RepRapLtd/Mendel-V1.0/Modified designs/Pix/20240402_110909.jpg

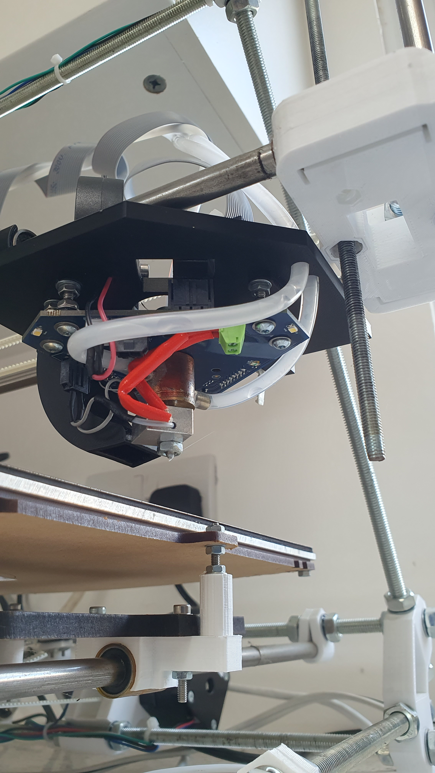
Modified designs/Pix/20240402_110909.jpg
