RepRapLtd/Mendel-V1.0/Modified designs/Pix/20240402_110834.jpg

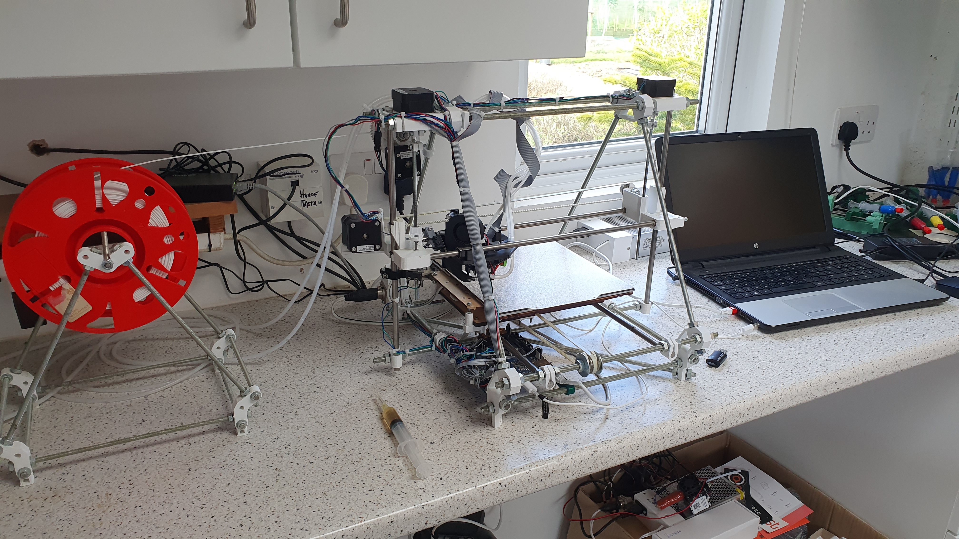
Modified designs/Pix/20240402_110834.jpg
