RepRapLtd/Mendel-V1.0/README

This is the RepRapPro Ltd version of Mendel.

See here for more details: http://reprappro.com/Mendel

See also the file dev-notes.
