RepRapLtd/Mendel-V1.0/gEDA/Heatbed/heatbed.png

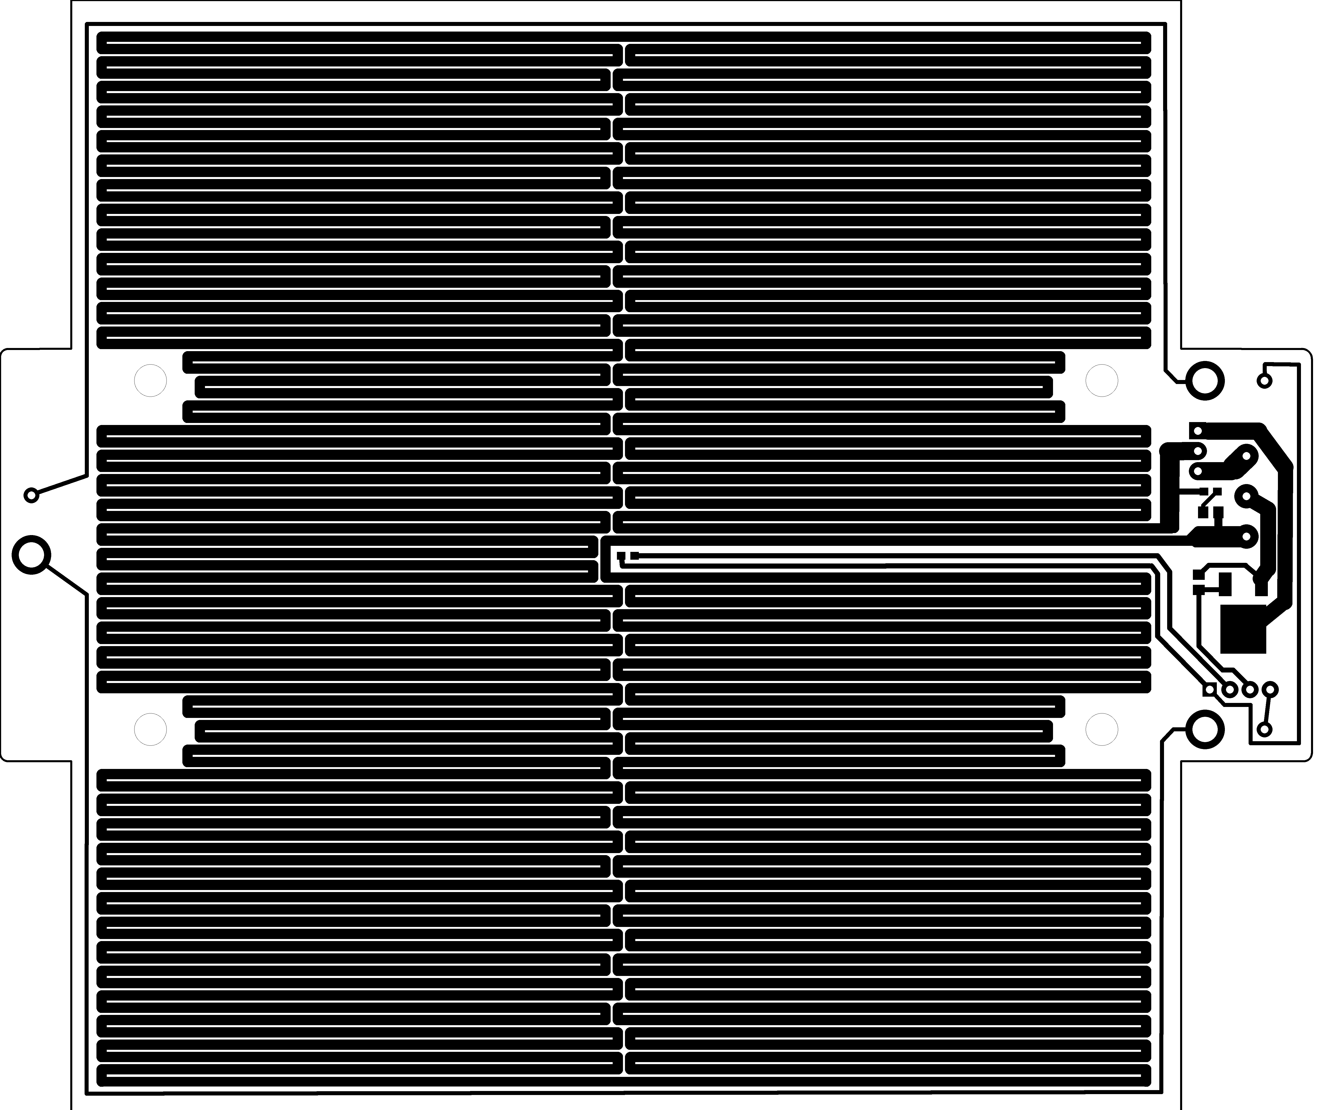
gEDA/Heatbed/heatbed.png
