RepRapLtd/Mendel-V1.0/Mult-material/README

RepRapPro Multi-material Mendel
===============================

These are the design files for the RepRapPro Multi-material Mendel.

This is work in progress.

http://reprappro.com
