RepRapLtd/Mendel-V1.0/RepRapPro-Mendel-BoM.ods

Sheet: Frame
Item | No off | Notes
 | Triangles
370mm M8 rods | 6 | 290mm between faces
Printed Frame vertex w. foot | 4
Printed Frame vertex | 2
U clips | 2
M8 nuts | 28
M8 lock washers | 28
 | X Links
330mm M8 rods | 4 | 273mm between faces
470mm M8 rods | 2
Printed U clips | 4
M8 mudguard washers | 2
M8 bearings | 2
M8 lock washers | 8
M8 washers | 28
M8 nuts | 46
M8 nuts | 12
M8 lock washers | 24
Printed XLR holder | 1
470mm M8 rods | 2
Printed Z motor holders | 2
Printed U clips | 2
M8 nuts | 12
M8 lock washers | 10
M8 washers | 6
XLR panel plug | 1
12mm M3 caps | 2
M3 washers | 2
M3 nuts | 2
400mm smooth rods (Y) | 2
350mm smooth rods (Z) | 2

Sheet: Y axis
Item | No off | Notes
 | Motor + mount
Printed Y motor mount | 1 | Nuts – 73mm from left
Printed Y motor lid | 1
Nema 17 motor | 1
M3 x 35mm screws | 3
M3 x 10mm set screw | 1
M3 nut | 1
M3 x 8mm screws | 2
Toothed belt pulley | 1
M3 washers | 3
 | Frog
Lasercut frog | 1 | Nuts – 22mm from left
LM8UU bearings | 3 | 175mm between Y rods
Printed bearing holders | 3
Printed 7mm belt clamps | 3
Printed belt guide | 1
Printed 4mm ridged belt clamp | 1
Printed ridged belt adjuster | 1
M3 x 35mm screws | 2
M3 x 30mm screws | 2
M3 x 20mm screws | 7
M3 nylock nut | 1
M3 nuts | 10
M3 washers | 20
 | Belt and stop
Toothed belt | 850mm
Printed XY endstop holder | 1
microswitch | 1
M2.5x15mm screws | 2
M2.5 washers | 4
M2.5 nuts | 2
M3x20mm screw | 1
M3 washers | 2
M3 nuts | 1

Sheet: X-axis
Item | No off | Notes
 | X carriage
Printed X carriage lid | 1
Printed X carriage plate | 1
Printed X belt clamp | 2
Cardboard heatshield | 1
Aluminium cooking foil | 110mm x 135mm
LM8UU bearings | 3
M3x20mm screws | 5
M3x35mm screws | 5
M3x30mm hex-head screws | 3
M3 nylock nut | 1
M3 nuts | 22
M3 washers | 27
 | Axis
Printed Xend motor | 1
Printed X end idler | 1
428mm smooth 8mm rods (X) | 2 | +0/-1 mm
8mm IGUS bearings | 4
M3 nylock nuts | 2
M3x16 screws | 2
 | Motor
NEMA 17 motor | 1
M3x10 screws | 4
M3 washers | 4
Toothed belt pulley | 1
M3 x 10mm set screw | 1
 | Idler
M8 threaded rod | 35mm
M8 nuts | 2
M8 mudguard washer | 1
8mm bearing | 1
M8 washers | 3

Sheet: Z-axis
Item | No off | Notes
 | Z drive
NEMA 17 motors | 2
60 mm springs | 2 | 0.5 wire, 7mm od
215mm M5 studding | 2
M5 nuts | 4
30mm x 5mm id poly tube | 2
Printed U clamps | 4
M3 x 20mm screws | 4
M3 nuts | 4
M3 x 10mm screws | 8
M3 washers | 12
 | Z endstop
M2.5x15mm screws | 2
M2.5 washers | 4
M2.5 nuts | 2
microswitch | 1
Printed Z-stop bracket | 1
Printed z-adjust wheel | 1
M3 x 35mm hex-head screw | 1
M3 x 20mm screws | 1
M3 nuts | 3
M3 washers | 4
15mm spring | 1 | 0.4 wire, 4.5mm od
 | X belt and endstop
Printed XY-stop bracket | 1
M2.5x15mm screws | 2
M2.5 washers | 4
M2.5 nuts | 2
microswitch | 1
M3 x 20mm screws | 1
M3 nuts | 1
M3 washers | 2
toothed belt | 1000mm

Sheet: Heated bed
Item | No off | Notes
Lasercut insulator | 1
PCB bed heater | 1
Glass printing plate | 1
Spring clips | 4
M3 x 50mm screws | 3
40mm springs | 3 | 0.6mm wire, 5.5mm od
M3 nuts | 9
M3 washers | 12
glue sachet | 1
thermistor | 1
heatshrink | 50mm
twin ribbon | 300mm

Sheet: Extruder drive
Item | No off | Notes
 | Motor and hobbed stud assembly | Same as Huxley, except for the fitting components, the 4mm PTFE, and the M4 bowden ends
M6 hobbed stud | 1
M6 full nut | 1
M6 nyloc nut | 2
M6 split washer | 1
M6 plain washer | 2
626 Bearing | 2
NEMA 14 stepper motor | 1
M3x10mm socket set screw | 1
M3 nut | 1
M3x8mm screws | 3
Printed M6 drive block | 1
Printed large gear | 1
Printed small gear | 1
 | Idler
M3x30mm screw | 1
626 bearing | 1
M3x45 screws | 2
M6x20mm socket set screw | 1
M3 washers | 6
M3 full nuts | 2
M3 nylock nut | 1
Springs | 2
Printed idler | 1
 | The Bowden tube
slotted brass retainer | 1 | M4 not M3
PTFE tube | 1
Printed tongue | 1
 | Fitting
M3 x 35mm screw | 1
M3x25mm countersunk screw | 1
M3 washers | 3
M3 nuts | 2
Printed extruder drive mount | 1
Printed PCB clip | 1

Sheet: Hot end
Item | No off | Notes
 |  | Same as Huxley except for brass union
Fan and heatsink | 1
Aluminium heater block | 1
M3x25 screws | 2
M3x16 screws | 2
Cable ties | 2
Stainless steel barrel | 1
M6 nyloc nut | 2
M6 split washer | 1
Brass union | 1 | M4 not M3
Brass nozzle | 1
100K thermistor | 1
6R8 heater resistor | 1
PTFE insulating cone | 1
PTFE spacer | 1
Aluminium cooling block | 1
connecting wire 20mm lengths | 4
crimps | 4
Heatshrink sleeve | 1
3mm PTFE tube (insert) | 15mm

Sheet: Wiring
Item | No off | Notes
Melzi PCB | 1
Printed PCB mounts | 3
M3 x 20mm screws | 3
M3 washers | 6
M3 nuts | 3
20A wire | 2m
heatshrink | 200mm
USB A to min B cable | 1
SD card + adapter | 1
12v Power supply | 1
Mains cable | 1
XLR line socket (metal shell) | 1
Cable ties | 100
PS shields/feet etc | ?

Sheet: Totals
sort | Item | No off
1 | 370mm M8 rods | 6 | 6
1 | M8 nuts | 100 | 28 | 46 | 12 | 12 | 2
1 | M8 lock washers | 70 | 28 | 8 | 24 | 10
1 | 330mm M8 rods | 4 | 4
1 | 470mm M8 rods | 2 | 2
1 | M8 mudguard washers | 3 | 2 | 1
1 | M8 washers | 37 | 28 | 6 | 3
1 | 470mm M8 rods | 2 | 2
1 | M3x12mm screws | 2 | 2
1 | M3 washers | 103 | 2 | 3 | 20 | 2 | 27 | 4 | 12 | 4 | 2 | 12 | 6 | 3 | 6
1 | M3 nuts | 61 | 2 | 1 | 10 | 1 | 22 | 4 | 3 | 1 | 9 | 1 | 2 | 2 | 3
1 | 400mm smooth rods (Y) | 2 | 2
1 | 350mm smooth rods (Z) | 2 | 2
1 | M3 x 35mm screws | 11 | 3 | 2 | 5 | 1
1 | M3 x 10mm set screw | 2 | 1 | 1
1 | M3 x 8mm screws | 5 | 2 | 3
1 | M3 x 30mm screws | 3 | 2 | 1
1 | M3 x 20mm screws | 21 | 7 | 1 | 3 | 4 | 1 | 1 | 1 | 3
1 | M3 nylock nut | 5 | 1 | 1 | 2 | 1
1 | M2.5x15mm screws | 6 | 2 | 2 | 2
1 | M2.5 washers | 12 | 4 | 4 | 4
1 | M2.5 nuts | 6 | 2 | 2 | 2
1 | M3x30mm hex-head screws | 3 | 3
1 | 428mm smooth 8mm rods (X) | 2 | 2
1 | M3x16 screws | 4 | 2 | 2
1 | M3x10 screws | 13 | 4 | 8 | 1
1 | 35mm M8 threaded rod | 1 | 1
1 | 215mm M5 studding | 2 | 2
1 | M5 nuts | 4 | 4
1 | M3 x 35mm hex-head screw | 1 | 1
1 | M3 x 50mm screws | 3 | 3
1 | M6 full nut | 1 | 1
1 | M6 nyloc nut | 4 | 2 | 2
1 | M6 split washer | 2 | 1 | 1
1 | M6 plain washer | 2 | 2
1 | M3x45 screws | 2 | 2
1 | M3x25mm countersunk screw | 1 | 1
1 | M3x25 screws | 2 | 2
2 | Printed Frame vertex w. foot | 4 | 4
2 | Printed Frame vertex | 2 | 2
2 | Printed U clips | 8 | 2 | 2 | 4
2 | Printed tube U clips | 4 | 4
2 | Printed XLR holder | 1 | 1
2 | Printed Z motor holders | 2 | 2
2 | Printed Y motor mount | 1 | 1
2 | Printed Y motor lid | 1 | 1
2 | Lasercut frog | 1 | 1
2 | Printed bearing holders | 3 | 3
2 | Printed 7mm belt clamps | 3 | 3
2 | Printed belt guide | 1 | 1
2 | Printed 4mm ridged belt clamp | 1 | 1
2 | Printed ridged belt adjuster | 1 | 1
2 | Printed XY endstop holder | 1 | 1
2 | Printed X carriage lid | 1 | 1
2 | Printed X carriage plate | 1 | 1
2 | Printed X belt clamp | 2 | 2
2 | Cardboard heatshield | 1 | 1
2 | Printed Xend motor | 1 | 1
2 | Printed X end idler | 1 | 1
2 | Toothed belt pulley | 2 | 1 | 1
2 | Printed Z-stop bracket | 1 | 1
2 | Printed z-adjust wheel | 1 | 1
2 | Printed XY-stop bracket | 1 | 1
2 | Printed M6 drive block | 1 | 1
2 | Printed large gear | 1 | 1
2 | Printed small gear | 1 | 1
2 | Printed idler | 1 | 1
2 | Printed tongue | 1 | 1
2 | Printed extruder drive mount | 1 | 1
2 | Printed PCB mounts | 4 | 3 | 1
3 | M8 bearings | 3 | 2 | 1
3 | LM8UU bearings | 6 | 3 | 3
3 | Toothed belt (mm) | 1850 | 850 | 1000
3 | Aluminium cooking foil | 0 | 110mm x 135mm
3 | 8mm IGUS bearings | 4 | 4
3 | 60 mm springs | 2 | 2
3 | 30mm x 5mm id poly tube | 2 | 2
3 | 15mm spring | 1 | 1
3 | Lasercut insulator | 1 | 1
3 | Glass printing plate | 1 | 1
3 | Spring clips | 4 | 4
3 | 40mm springs | 3 | 3
3 | glue sachet | 1 | 1
3 | M6 hobbed stud | 1 | 1
3 | 626 Bearing | 3 | 2 | 1
3 | Springs | 2 | 2
3 | slotted brass retainer | 1 | 1
3 | PTFE tube | 1 | 1
3 | Aluminium heater block | 1 | 1
3 | Cable ties | 100 | 2 | 98
3 | Stainless steel barrel | 1 | 1
3 | Brass union | 1 | 1
3 | Brass nozzle | 1 | 1
3 | PTFE insulating cone | 1 | 1
3 | PTFE spacer | 1 | 1
3 | Aluminium cooling block | 1 | 1
3 | 3mm PTFE tube (insert – mm) | 15 | 15
4 | XLR panel plug | 1 | 1
4 | Nema 17 motor | 4 | 1 | 1 | 2
4 | microswitch | 3 | 1 | 1 | 1
4 | PCB bed heater | 1 | 1
4 | thermistor | 1 | 1
4 | Heatshrink (mm) | 50 | 50
4 | twin ribbon (mm) | 300 | 300
4 | NEMA 14 stepper motor | 1 | 1
4 | Fan and heatsink | 1 | 1
4 | 100K thermistor | 1 | 1
4 | 6R8 heater resistor | 1 | 1
4 | connecting wire 20mm lengths | 4 | 4
4 | crimps | 4 | 4
4 | Heatshrink sleeve (mm) | 300 | 100 | 200
4 | Melzi PCB | 1 | 1
4 | 20A wire (m) | 2 | 2
4 | USB A to min B cable | 1 | 1
4 | SD card + adapter | 1 | 1
4 | 12v Power supply | 1 | 1
4 | Mains cable | 1 | 1
4 | XLR line socket (metal shell) | 1 | 1
4 | PS shields/feet etc | 0 | ?
