RepRapLtd/Mendel-V1.0/dxf/cardboard-heat-shield.dxf

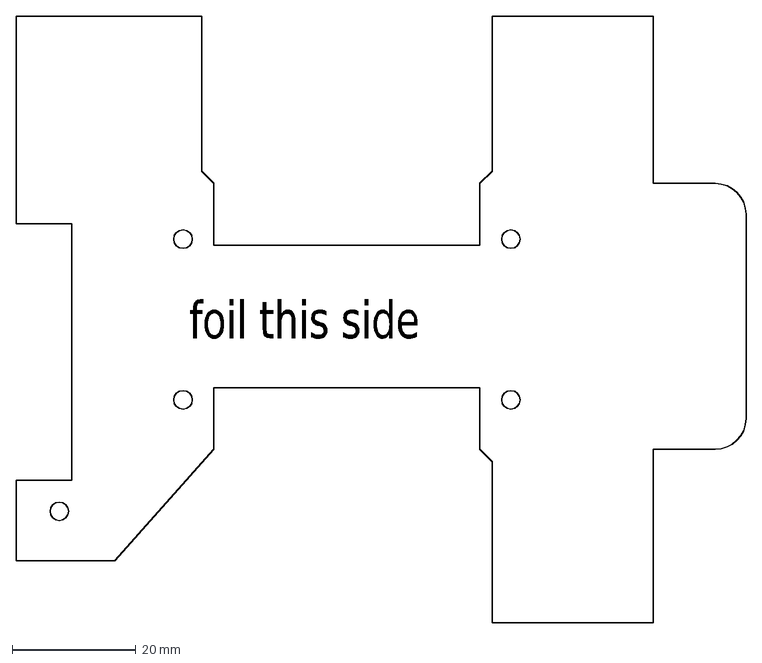
[picture p5: CAD file, 2020-08-14]
dxf/cardboard-heat-shield.dxf
foil this side
