RepRapLtd/Mendel-V1.0/Modified designs/STLs/switch-probe-x-carriage-lever.stl

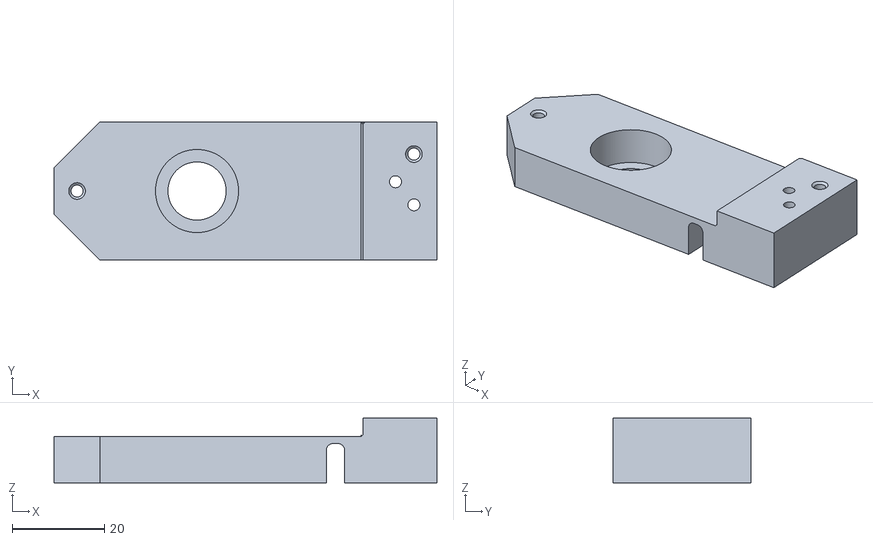
[picture p6: CAD file, 2024-06-14]
Modified designs/STLs/switch-probe-x-carriage-lever.stl
83.0 x 30.0 x 14.0
