RepRapLtd/Mendel-V1.0/Modified designs/switch-probe-x-carriage.FCStd

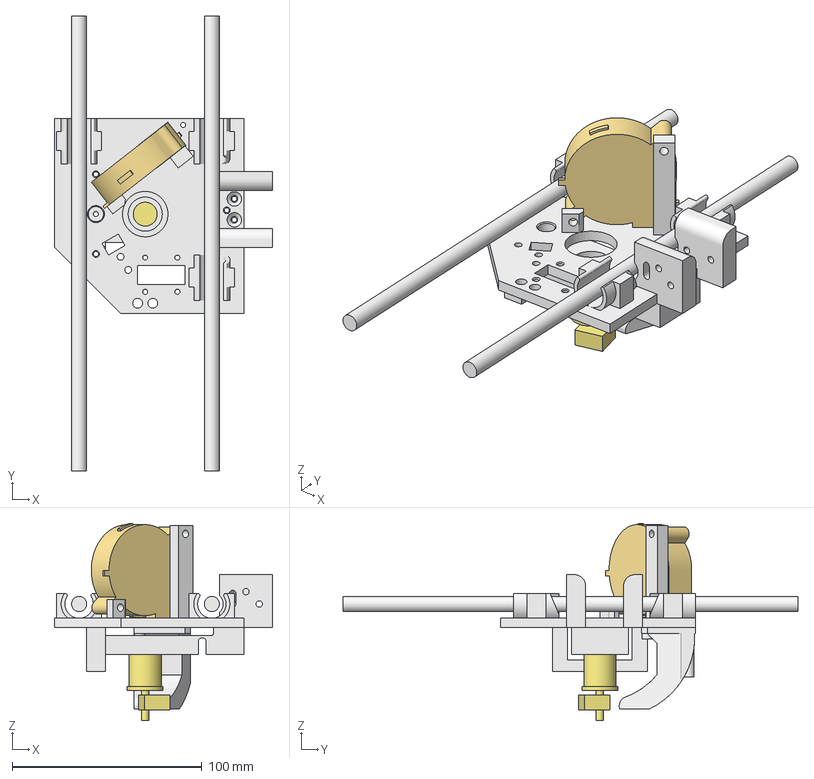
[picture p7: CAD file, 2024-06-14]
Modified designs/switch-probe-x-carriage.FCStd
115.0 x 240.0 x 104.0 mm
8mm rod-1
8mm rod 2
hot-end
duct-j
lever
carriage
contact-bridge
snail-fan
