RepRapLtd/Mendel-V1.0/Mult-material/Print-mendel-mult-material/Individual-STLs/small-gear-1off.stl

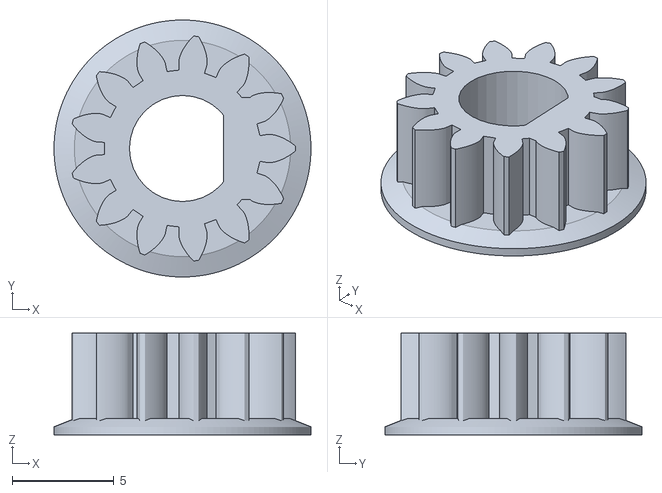
[picture p8: CAD file, 2020-08-14]
Mult-material/Print-mendel-mult-material/Individual-STLs/small-gear-1off.stl
12.6 x 12.6 x 5.00
