RepRapLtd/Mendel-V1.0/Openscad/x-carriage.FCStd

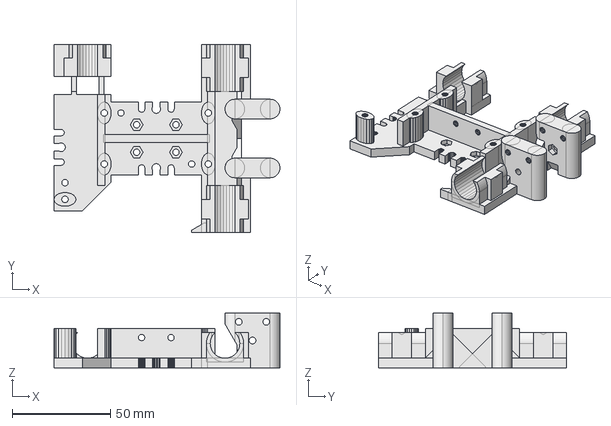
[picture p9: CAD file, 2023-07-14]
Openscad/x-carriage.FCStd
115.1 x 96.0 x 28.0 mm
