RepRapLtd/Mendel-V1.0/Print-mendel/Mendel-trays-STLs/Tray-1/Tray1B.stl

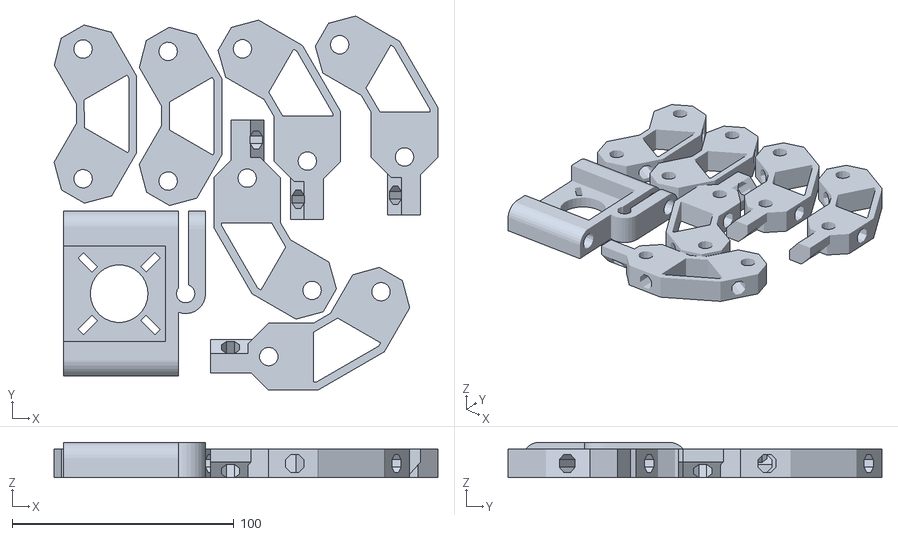
[picture p10: CAD file, 2020-08-14]
Print-mendel/Mendel-trays-STLs/Tray-1/Tray1B.stl
173.2 x 168.7 x 16.0
