RepRapLtd/Mendel-V1.0/Print-mendel/Mendel-trays-STLs/Tray-2/Tray2B.stl

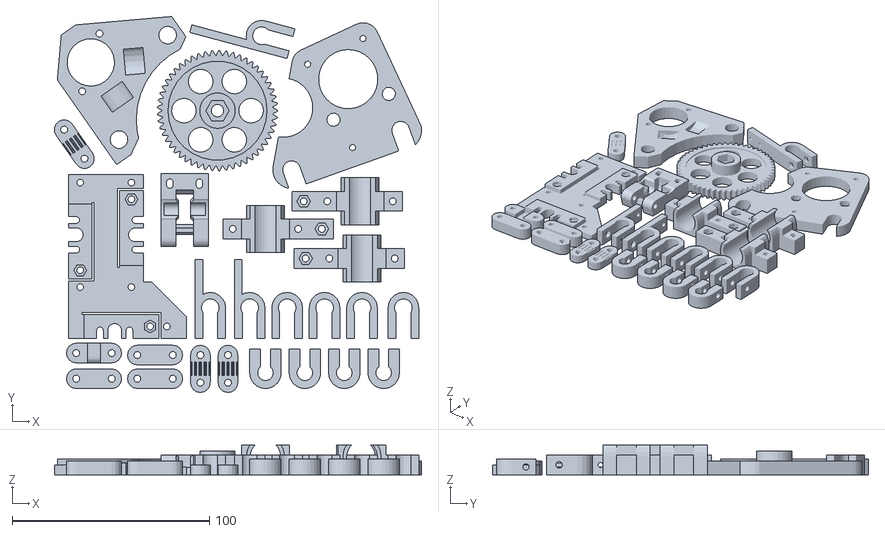
[picture p11: CAD file, 2020-08-14]
Print-mendel/Mendel-trays-STLs/Tray-2/Tray2B.stl
186.3 x 190.8 x 15.0
