RepRapLtd/Mendel-V1.0/Print-mendel/Mendel-trays-STLs/Tray-3/Tray3B.stl

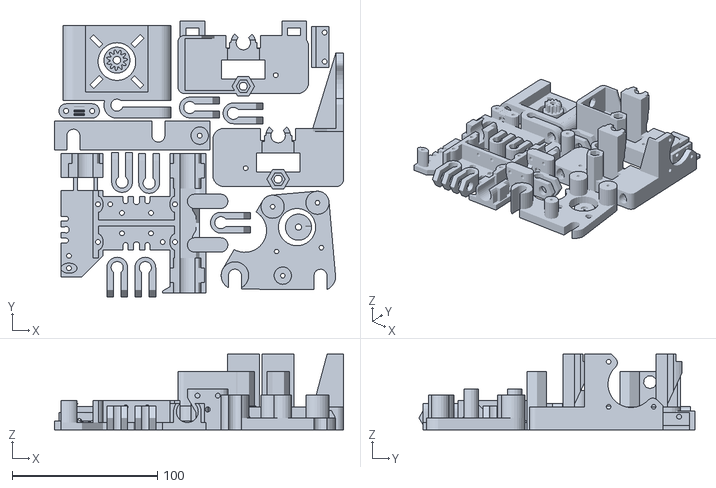
[picture p12: CAD file, 2020-08-14]
Print-mendel/Mendel-trays-STLs/Tray-3/Tray3B.stl
199.0 x 190.1 x 52.0
