RepRapLtd/Mendel-V1.0/Quickset-x-carriage/x-carriage-and-lid.FCStd

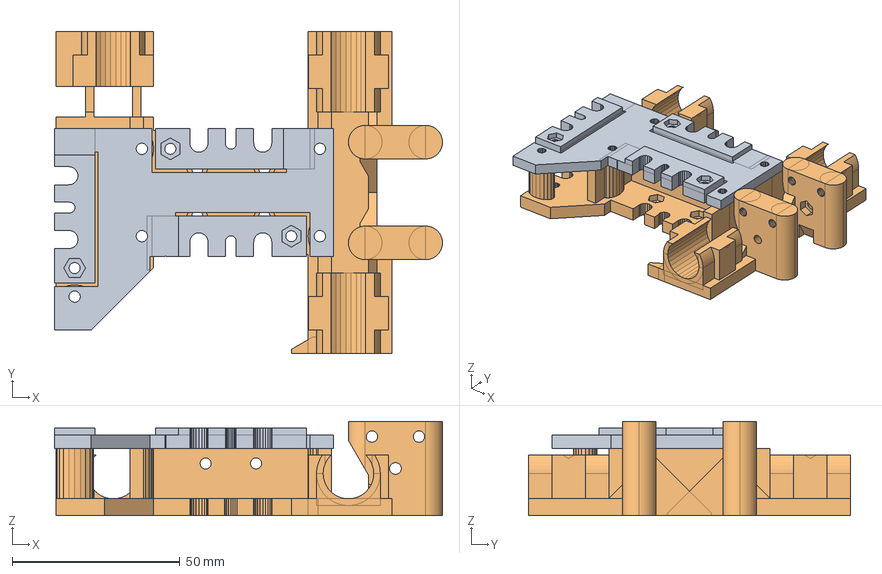
[picture p13: CAD file, 2020-08-18]
Quickset-x-carriage/x-carriage-and-lid.FCStd
115.5 x 96.0 x 28.0 mm
x-lid
x-carriage
