RepRapLtd/Mendel-V1.0/dxf/ybracproject.dxf

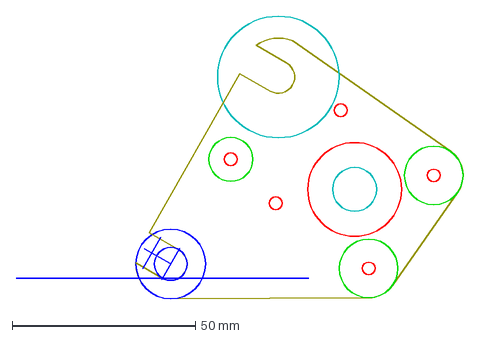
[picture p14: CAD file, 2020-08-14]
dxf/ybracproject.dxf
123.2 x 77.2 mm
