RepRapLtd/Mendel-V1.0/Modified designs/smart-effector-x-carriage.FCStd

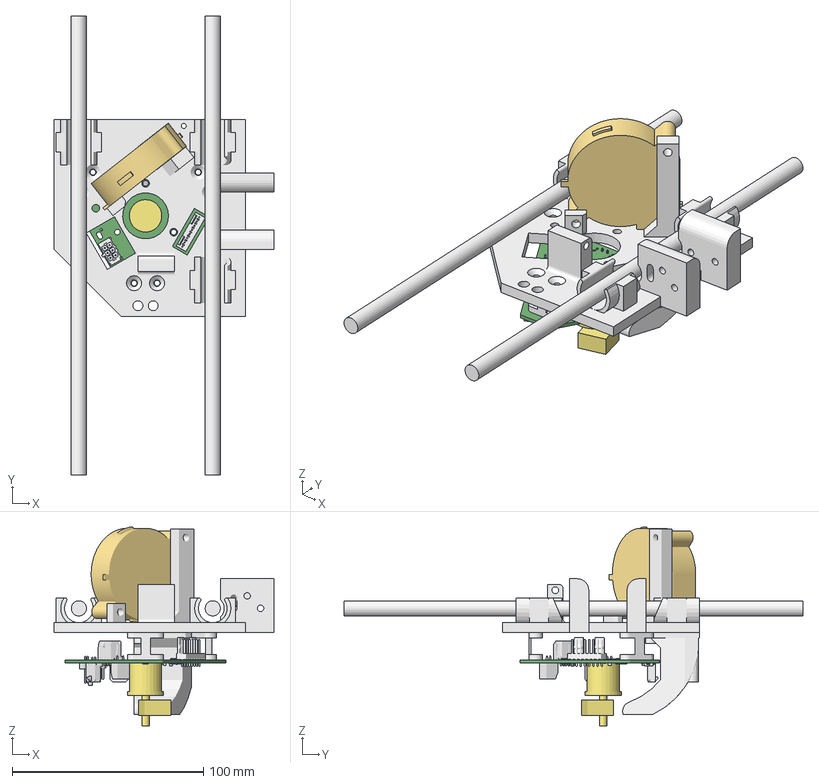
[picture p15: CAD file, 2024-03-04]
Modified designs/smart-effector-x-carriage.FCStd
115.0 x 240.0 x 104.0 mm
8mm rod-1
8mm rod 2
hot-end
spacer
spacer001
duct-j
carriage-p
snail-fan
