RepRapLtd/Mendel-V1.0/Modified designs/STLs/switch-probe-contact-bridge.stl

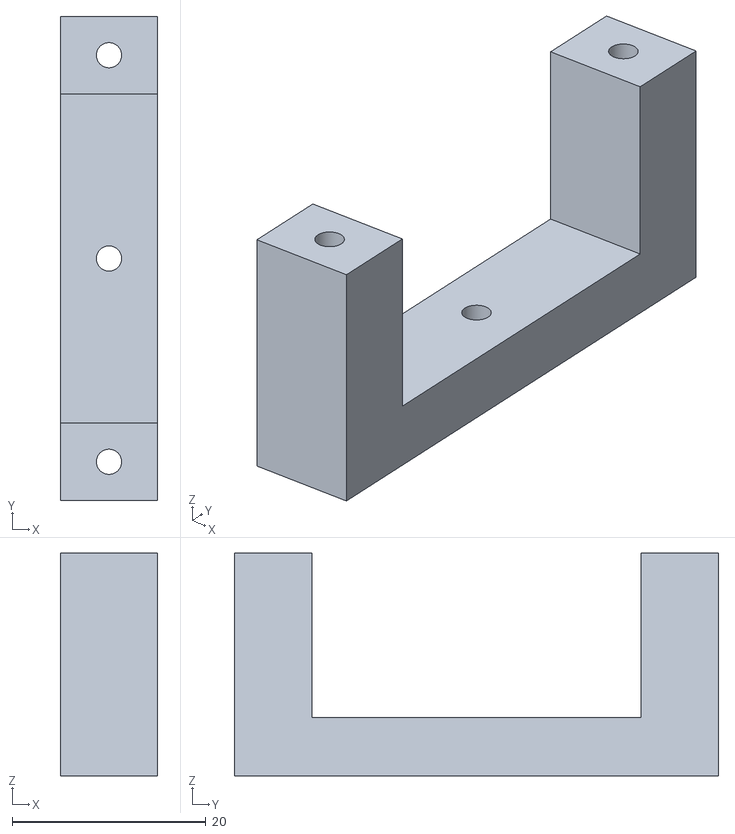
[picture p16: CAD file, 2024-06-14]
Modified designs/STLs/switch-probe-contact-bridge.stl
10.0 x 50.0 x 23.0
