RepRapLtd/Mendel-V1.0/Mult-material/Print-mendel-mult-material/Individual-STLs/frame-clip-tab-1off.stl

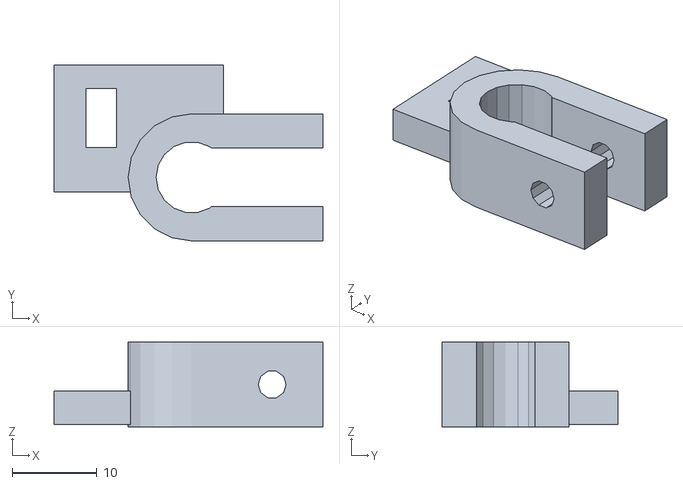
[picture p17: CAD file, 2020-08-14]
Mult-material/Print-mendel-mult-material/Individual-STLs/frame-clip-tab-1off.stl
31.8 x 20.8 x 10.0
