RepRapLtd/Mendel-V1.0/Print-mendel/Individual-STLs/hot-end-pcb-bracket-1off.stl

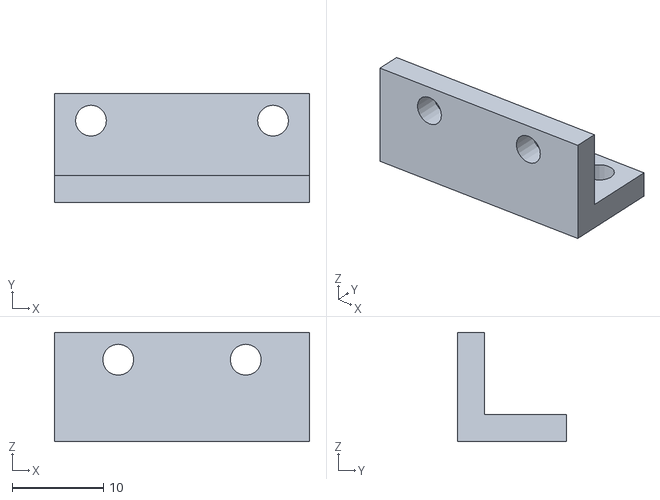
[picture p18: CAD file, 2020-08-14]
Print-mendel/Individual-STLs/hot-end-pcb-bracket-1off.stl
28.0 x 12.0 x 12.0
