RepRapLtd/Mendel-V1.0/Quickset-x-carriage/mendel-1-x-lid.stl

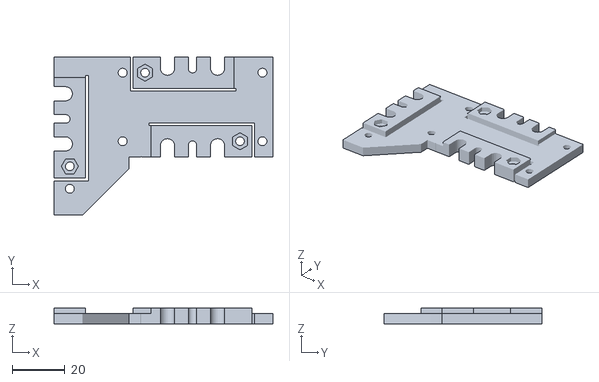
[picture p19: CAD file, 2020-08-18]
Quickset-x-carriage/mendel-1-x-lid.stl
83.0 x 60.0 x 6.00
