RepRapLtd/Mendel-V1.0/dxf/y-frog.dxf

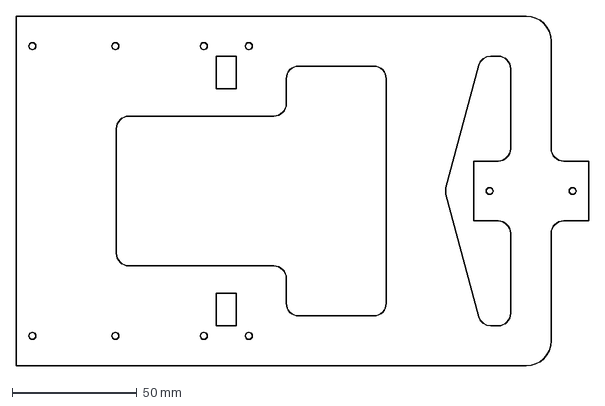
[picture p20: CAD file, 2020-08-14]
dxf/y-frog.dxf
229.0 x 140.0 mm
