RepRapLtd/Mendel-V1.0/Modified designs/smart-effector-x-carriage-duct-e.stl

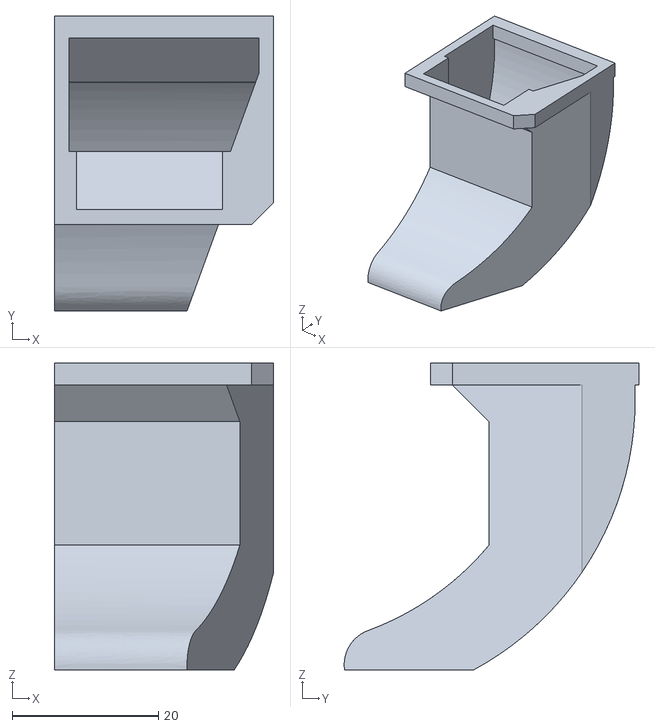
[picture p21: CAD file, 2024-03-01]
Modified designs/smart-effector-x-carriage-duct-e.stl
30.0 x 40.3 x 42.0
