RepRapLtd/Mendel-V1.0/Modified designs/STLs/switch-probe-x-carriage-spring-test.stl

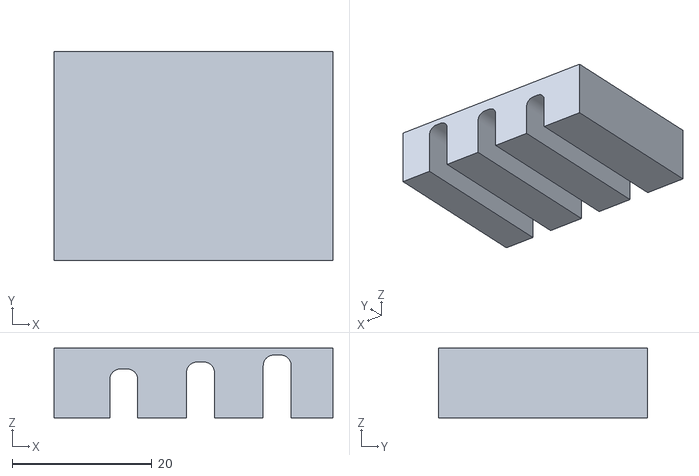
[picture p22: CAD file, 2024-05-09]
Modified designs/STLs/switch-probe-x-carriage-spring-test.stl
40.0 x 30.0 x 10.0
