RepRapLtd/Mendel-V1.0/Mult-material/Print-mendel-mult-material/Individual-STLs/spacer-1off.stl

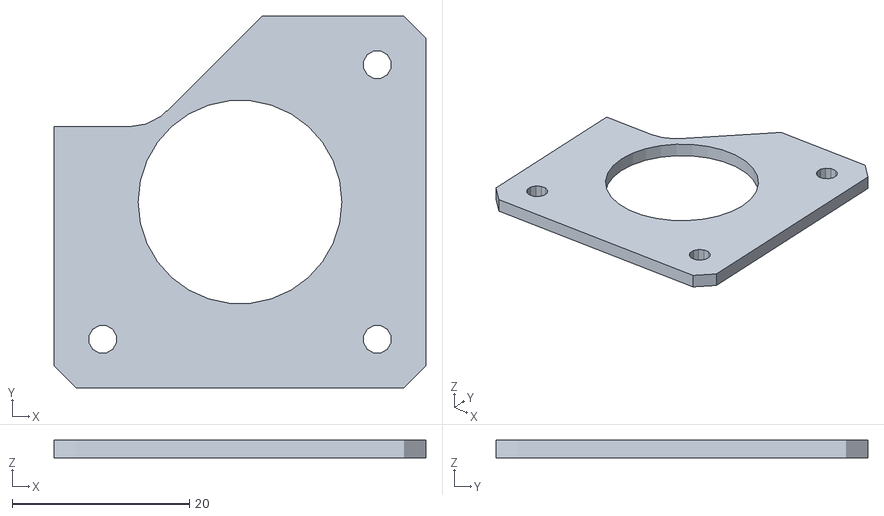
[picture p23: CAD file, 2020-08-14]
Mult-material/Print-mendel-mult-material/Individual-STLs/spacer-1off.stl
42.0 x 42.0 x 2.00
