RepRapLtd/Mendel-V1.0/Print-mendel/Individual-STLs/M6-Block-1off.stl

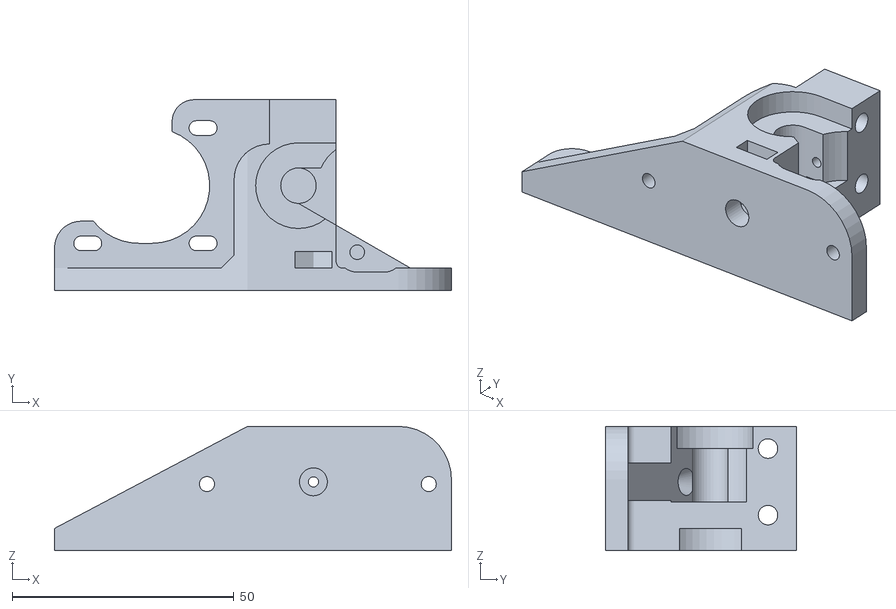
[picture p24: CAD file, 2020-08-14]
Print-mendel/Individual-STLs/M6-Block-1off.stl
89.5 x 43.0 x 28.0
