RepRapLtd/Mendel-V1.0/Quickset-x-carriage/mendel-1-x-carriage-plate.stl

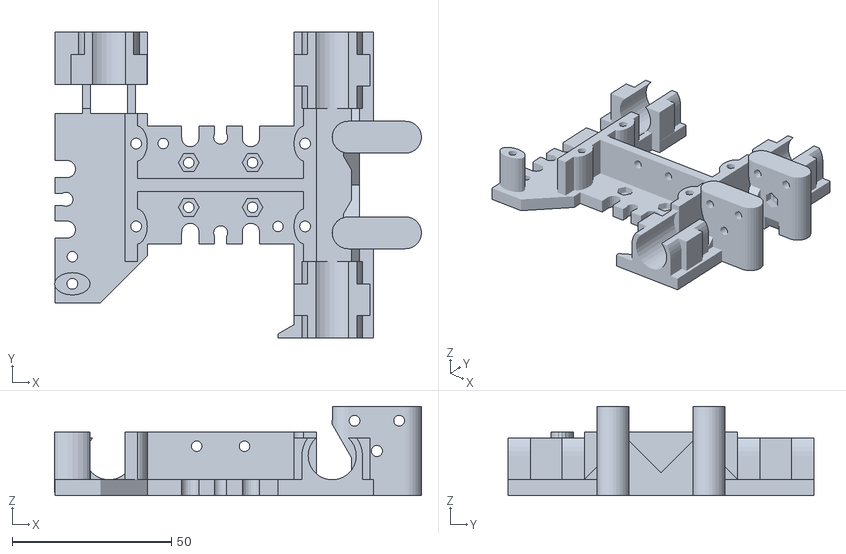
[picture p25: CAD file, 2020-08-18]
Quickset-x-carriage/mendel-1-x-carriage-plate.stl
115.1 x 96.0 x 28.0
