RepRapLtd/Mendel-V1.0/dxf/alternate-cooling-block.dxf

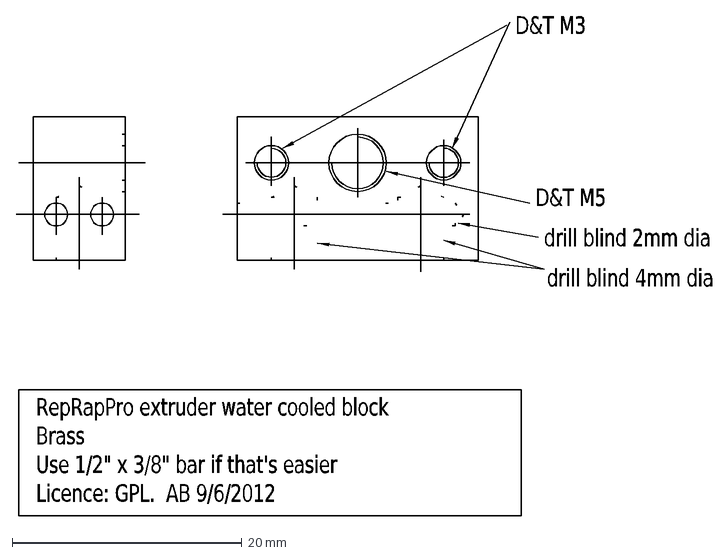
[picture p26: CAD file, 2020-08-14]
dxf/alternate-cooling-block.dxf
D&T\~M3
D&T\~M5
drill\~blind\~2mm\~dia
drill\~blind\~4mm\~dia
RepRapPro\~extruder\~water\~cooled\~block Brass Use\~1/2"\~x\~3/8"\~bar\~if\~that's\~easier Licence:\~GPL.\~\~AB\~9/6/2012
