RepRapLtd/Mendel-V1.0/Modified designs/bed-mount.FCStd

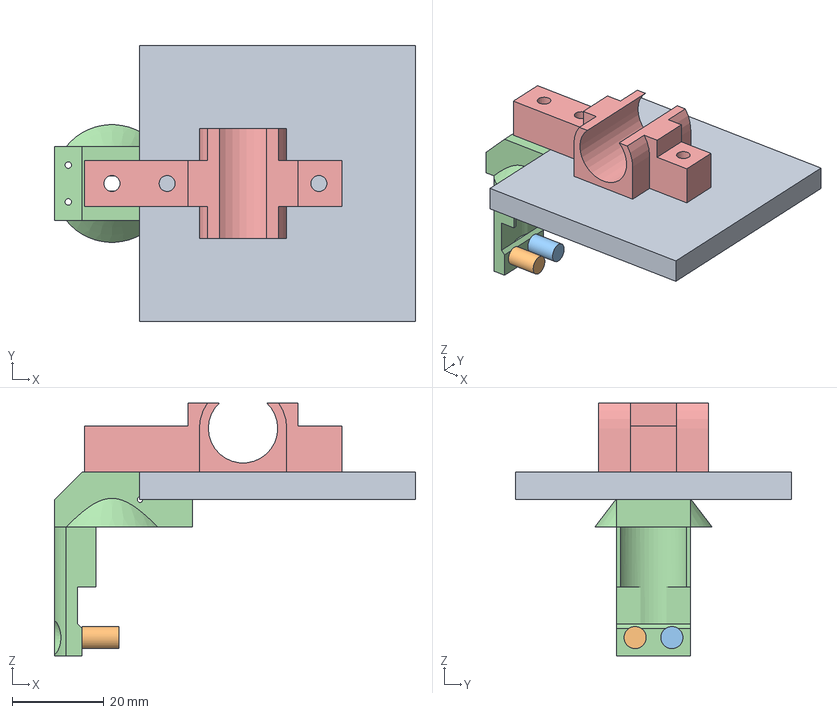
[picture p27: CAD file, 2024-02-01]
Modified designs/bed-mount.FCStd
78.5 x 60.0 x 55.0 mm
bed-base
block-0
y-bearing-mount-3off
