RepRapLtd/Mendel-V1.0/Modified designs/STLs/smart-effector-lower-duct.stl

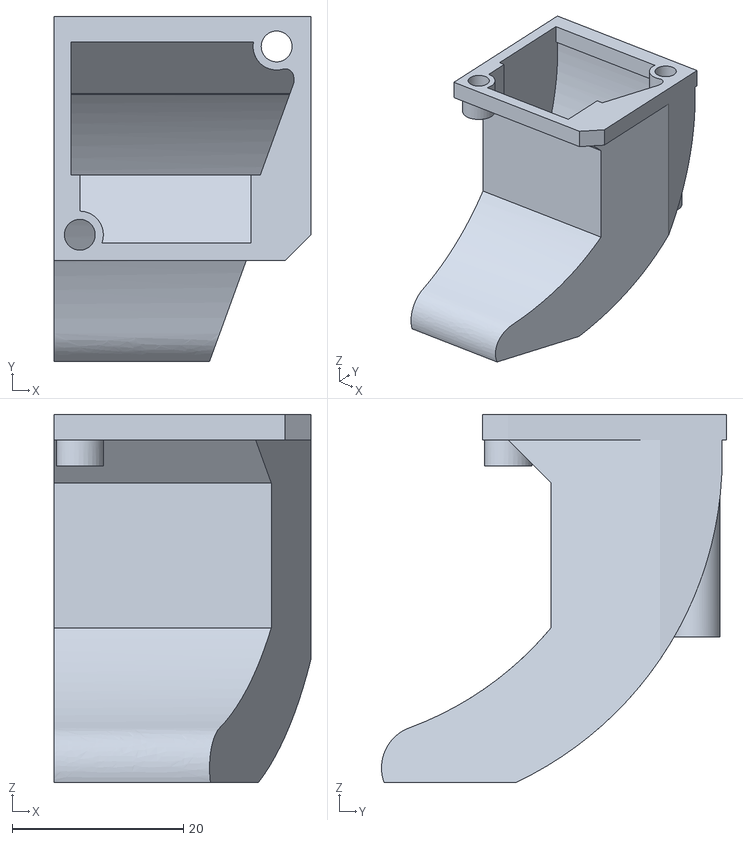
[picture p28: CAD file, 2024-03-04]
Modified designs/STLs/smart-effector-lower-duct.stl
30.0 x 40.3 x 43.0
