RepRapLtd/Mendel-V1.0/Mult-material/Print-mendel-mult-material/Individual-STLs/extruder-drive-1off.stl

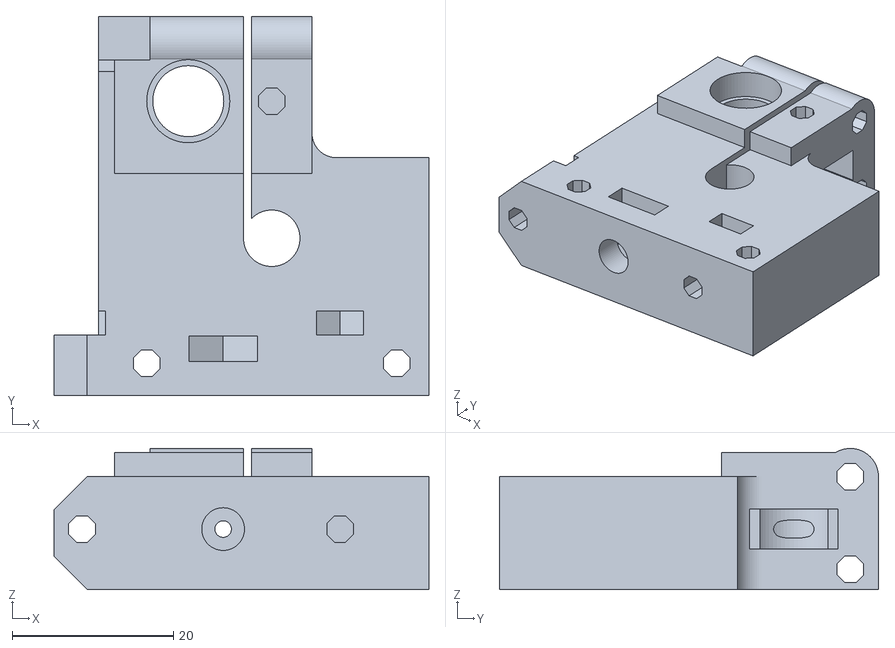
[picture p29: CAD file, 2020-08-14]
Mult-material/Print-mendel-mult-material/Individual-STLs/extruder-drive-1off.stl
46.5 x 47.0 x 17.5
