RepRapLtd/Mendel-V1.0/Print-mendel/Individual-STLs/coupling-4off.stl

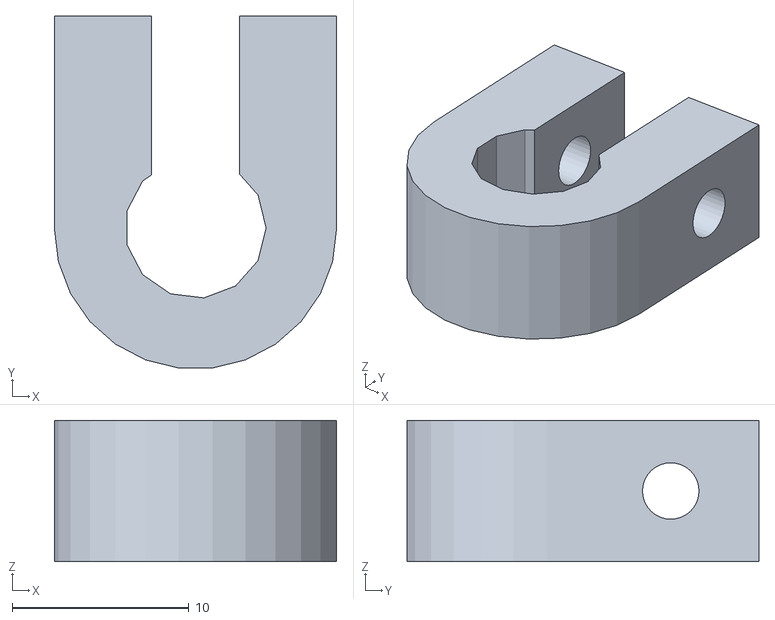
[picture p30: CAD file, 2020-08-14]
Print-mendel/Individual-STLs/coupling-4off.stl
16.0 x 19.9 x 8.00
