RepRapLtd/Mendel-V1.0/dxf/hobbed-insert.dxf

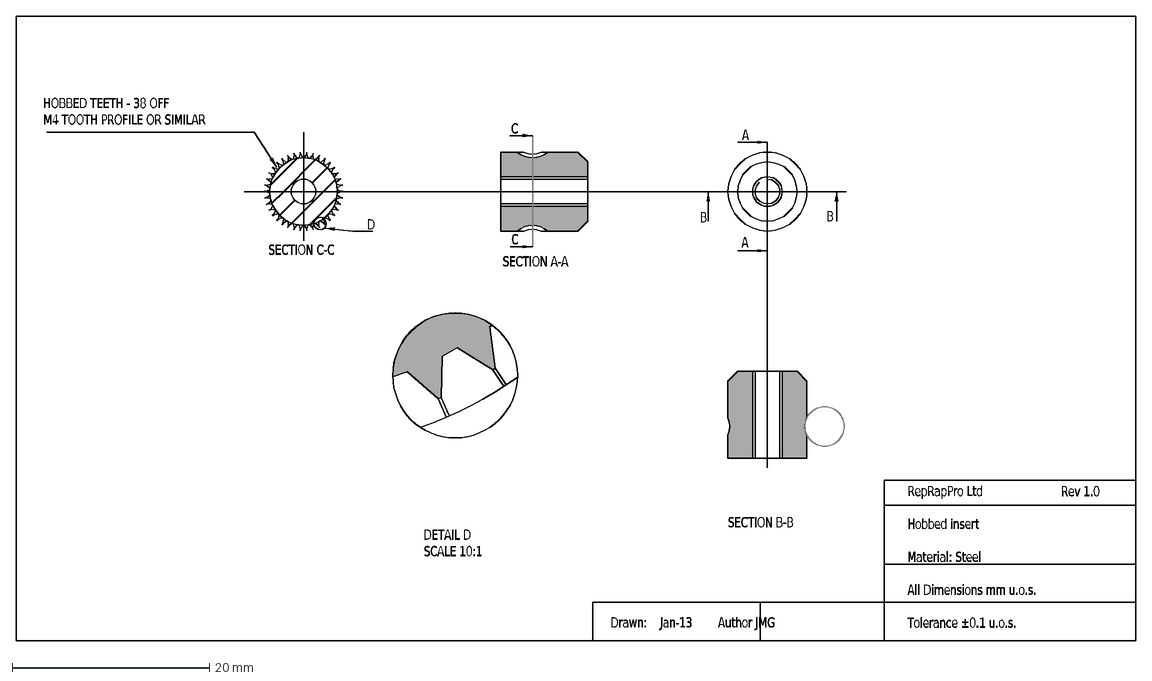
[picture p31: CAD file, 2020-08-14]
dxf/hobbed-insert.dxf
A
B
C
SECTION A-A
SECTION B-B
HOBBED TEETH - 38 OFF M4 TOOTH PROFILE OR SIMILAR
SECTION C-C
D
DETAIL D SCALE 10:1
RepRapPro Ltd Hobbed insert Material: Steel All Dimensions mm u.o.s. Tolerance ±0.1 u.o.s.
Rev 1.0
Drawn: Jan-13 Author JMG
