RepRapLtd/Mendel-V1.0/Modified designs/hot-end.FCStd

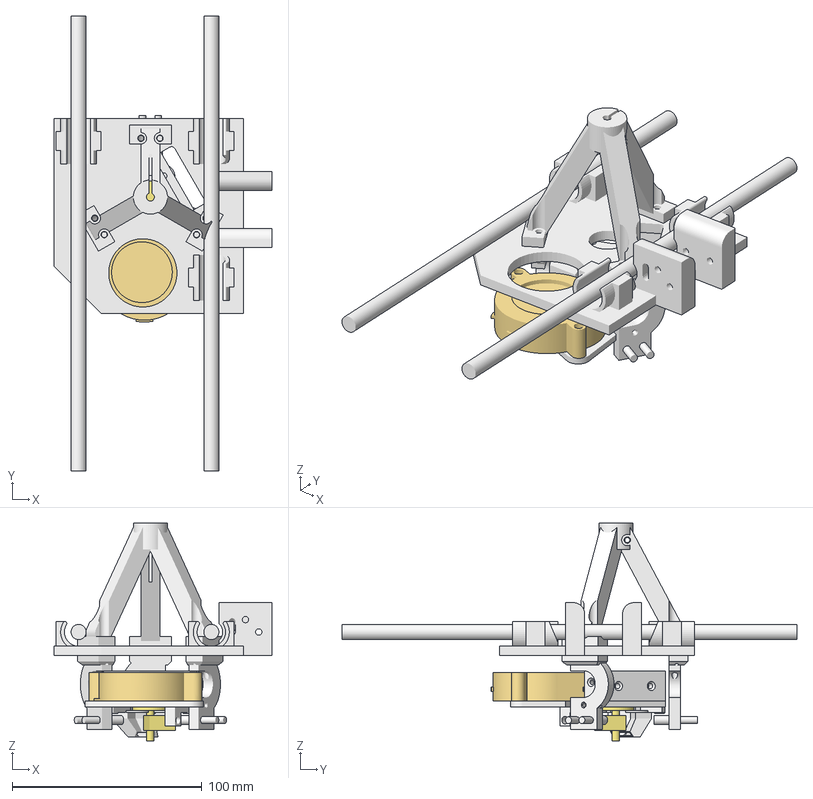
[picture p32: CAD file, 2023-10-23]
Modified designs/hot-end.FCStd
115.0 x 240.0 x 115.0 mm
washer-1
washer-2
hot-end
contact-007
contact-008
contact-1-screw003
contact-2-screw003
contact-009
contact-010
contact-1-screw004
contact-2-screw004
contact-011
contact-012
contact-1-screw005
contact-2-screw005
block-j
8mm rod-1
8mm rod 2
carriage
contact-013
contact-014
plate
contact-mount-005
contact-mount-011
contact-mount-015 (Mirror #20)
print-cool-duct
spacer
ptfe-support
fan
