RepRapLtd/Mendel-V1.0/Modified designs/STLs/smart-effector-x-carriage-spacer.stl

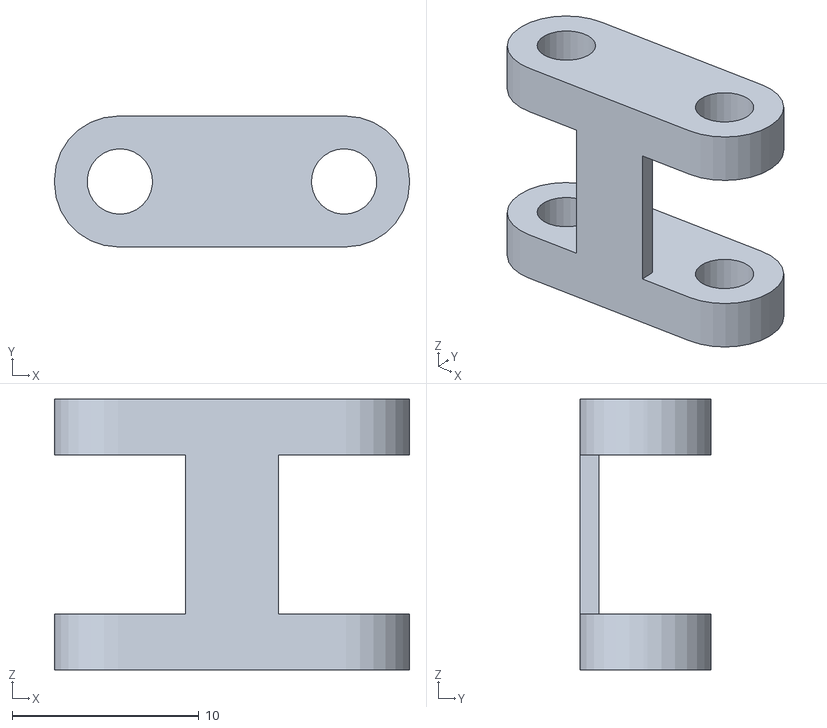
[picture p33: CAD file, 2024-02-08]
Modified designs/STLs/smart-effector-x-carriage-spacer.stl
19.0 x 7.00 x 14.5
