RepRapLtd/Mendel-V1.0/Mult-material/Print-mendel-mult-material/Individual-STLs/frame-clip-2off.stl

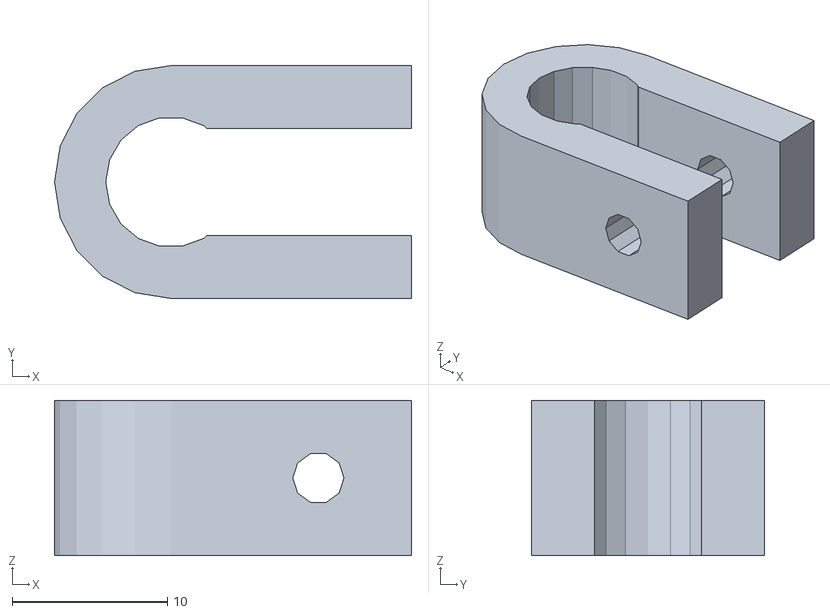
[picture p34: CAD file, 2020-08-14]
Mult-material/Print-mendel-mult-material/Individual-STLs/frame-clip-2off.stl
23.0 x 15.0 x 10.0
