RepRapLtd/Mendel-V1.0/Print-mendel/Individual-STLs/tongue-1off.stl

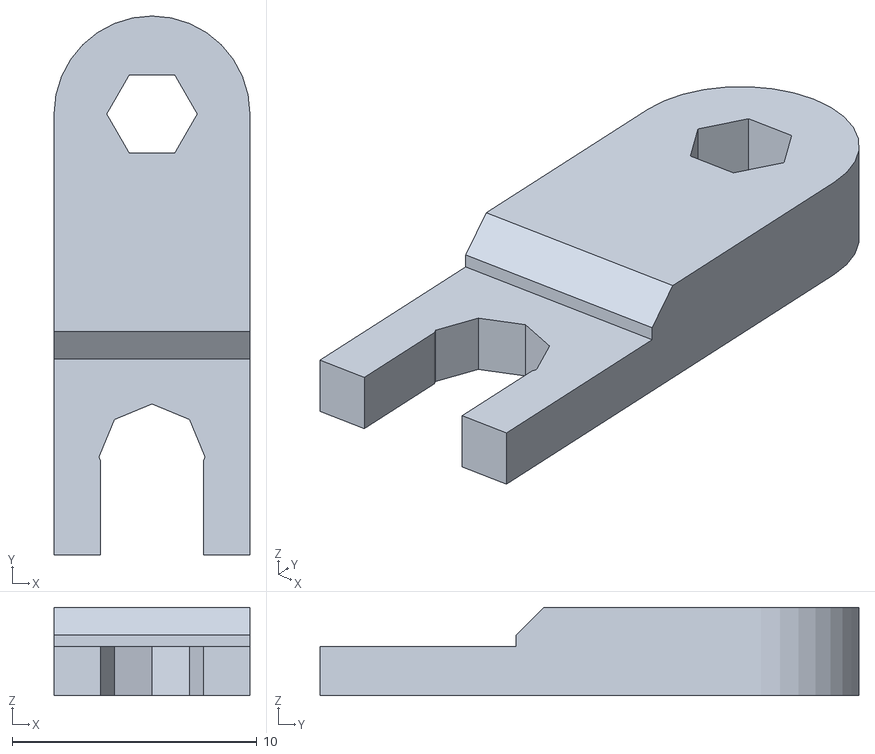
[picture p35: CAD file, 2020-08-14]
Print-mendel/Individual-STLs/tongue-1off.stl
8.00 x 22.0 x 3.60
