RepRapLtd/Mendel-V1.0/dxf/vertex-body-fixed-qcad.dxf

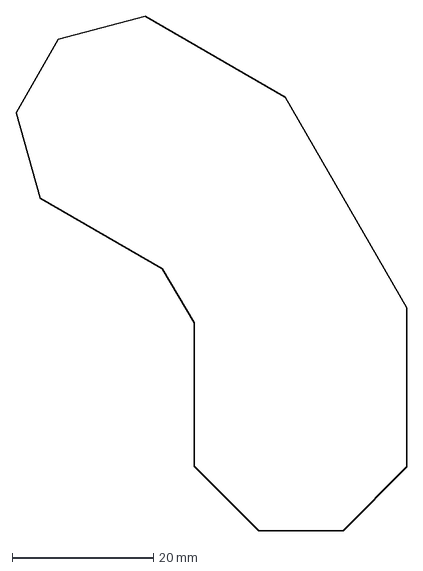
[picture p36: CAD file, 2020-08-14]
dxf/vertex-body-fixed-qcad.dxf
55.4 x 72.9 mm
