RepRapLtd/Mendel-V1.0/Modified designs/STLs/smart-effector-x-carriage-probe.stl

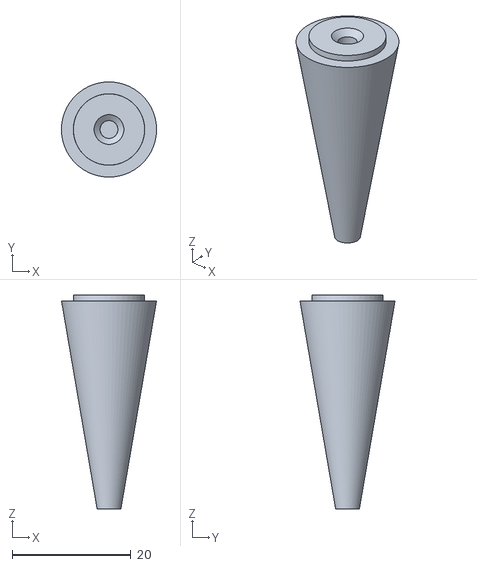
[picture p37: CAD file, 2024-02-05]
Modified designs/STLs/smart-effector-x-carriage-probe.stl
16.0 x 16.0 x 36.0
