RepRapLtd/Mendel-V1.0/Modified designs/X Carriage - bed probe.FCStd

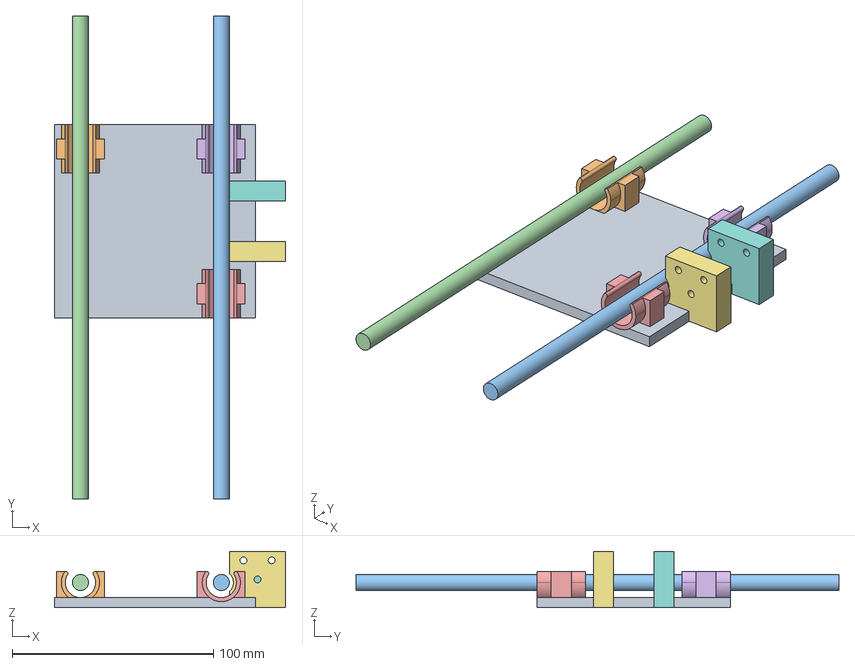
[picture p38: CAD file, 2023-08-02]
Modified designs/X Carriage - bed probe.FCStd
115.0 x 240.0 x 28.0 mm
8mm rod-1
8mm rod 2
belt-block-2-b
belt-block-1-b
