RepRapLtd/Mendel-V1.0/Print-mendel/Individual-STLs/xy-endstop-2off.stl

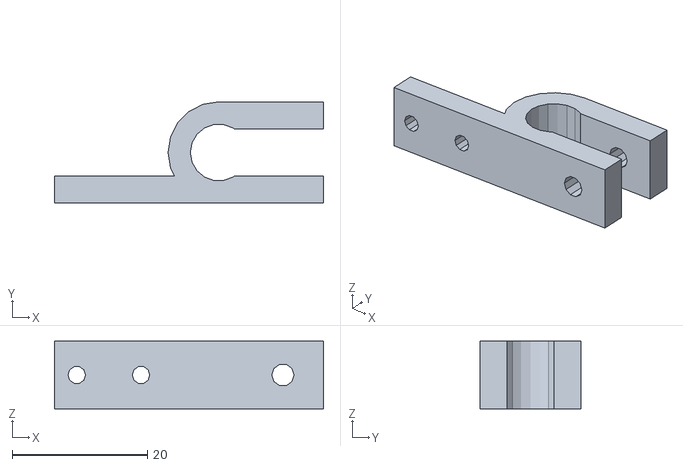
[picture p39: CAD file, 2020-08-14]
Print-mendel/Individual-STLs/xy-endstop-2off.stl
39.8 x 15.0 x 10.0
