RepRapLtd/Mendel-V1.0/dxf/ybracproj_extr.dxf

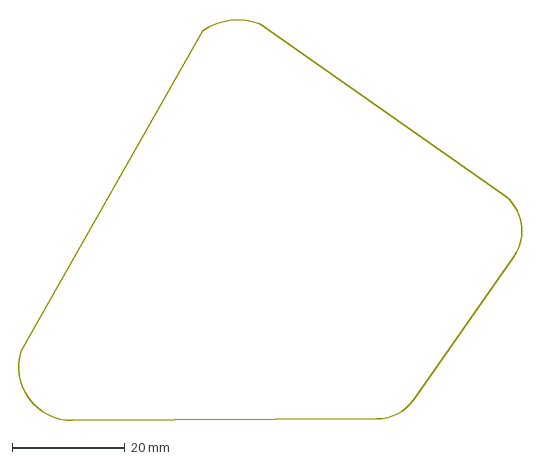
[picture p40: CAD file, 2020-08-14]
dxf/ybracproj_extr.dxf
90.9 x 71.8 mm
