RepRapLtd/Mendel-V1.0/Modified designs/X Carriage - bed probe bearing holder check.stl

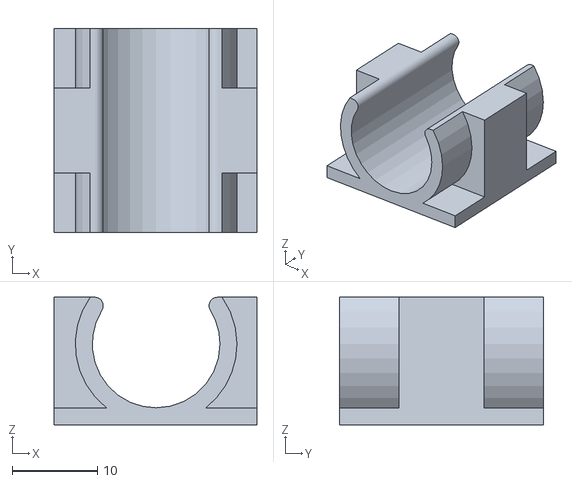
[picture p41: CAD file, 2023-07-14]
Modified designs/X Carriage - bed probe bearing holder check.stl
23.9 x 24.0 x 15.0
