RepRapLtd/Mendel-V1.0/Mult-material/Print-mendel-mult-material/Individual-STLs/large-gear-1off.stl

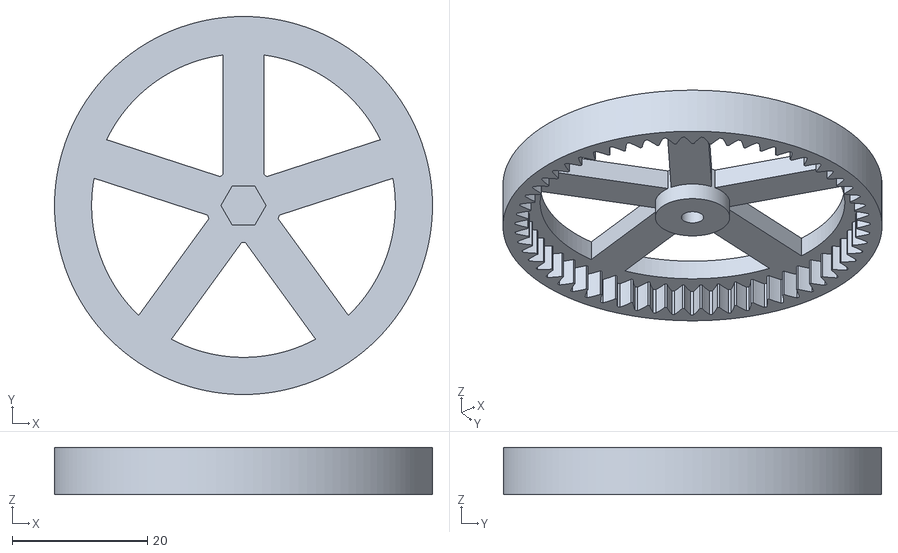
[picture p42: CAD file, 2020-08-14]
Mult-material/Print-mendel-mult-material/Individual-STLs/large-gear-1off.stl
56.0 x 56.0 x 7.00
