RepRapLtd/Mendel-V1.0/Print-mendel/Individual-STLs/large-gear-1off.stl

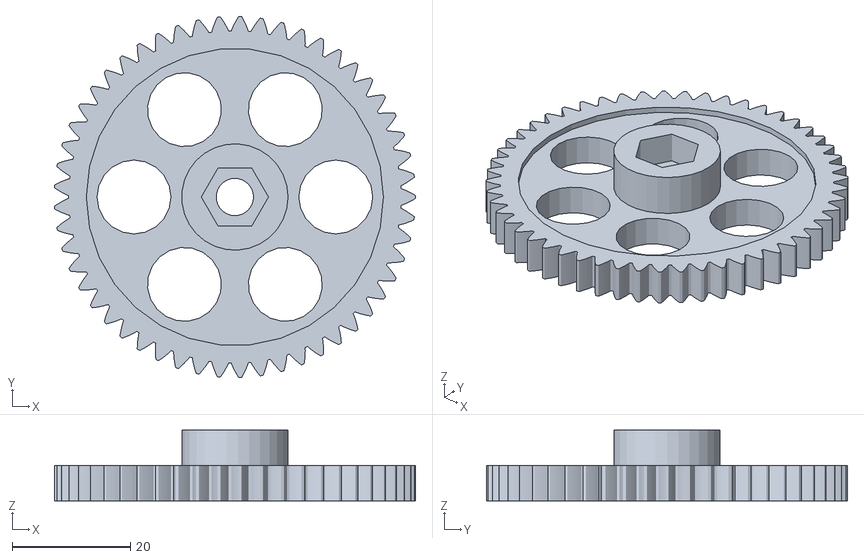
[picture p43: CAD file, 2020-08-14]
Print-mendel/Individual-STLs/large-gear-1off.stl
61.1 x 61.1 x 12.0
