RepRapLtd/Mendel-V1.0/dxf/vertex-body-hole-qcad.dxf

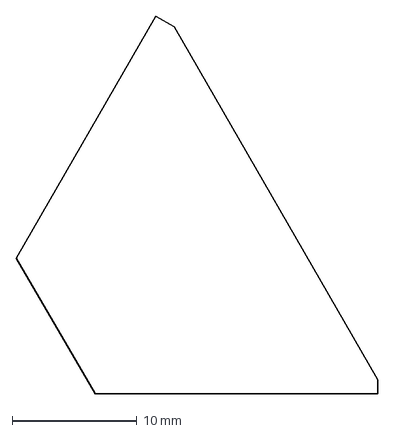
[picture p44: CAD file, 2020-08-14]
dxf/vertex-body-hole-qcad.dxf
29.0 x 30.2 mm
