RepRapLtd/Mendel-V1.0/Modified designs/fan.stl

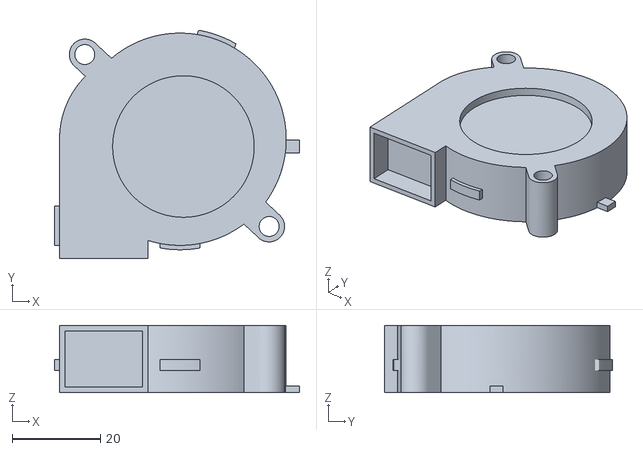
[picture p45: CAD file, 2023-07-14]
Modified designs/fan.stl
55.4 x 51.7 x 15.2
