RepRapLtd/Mendel-V1.0/Modified designs/STLs/hot-end-mdf-plate-x-section.dxf

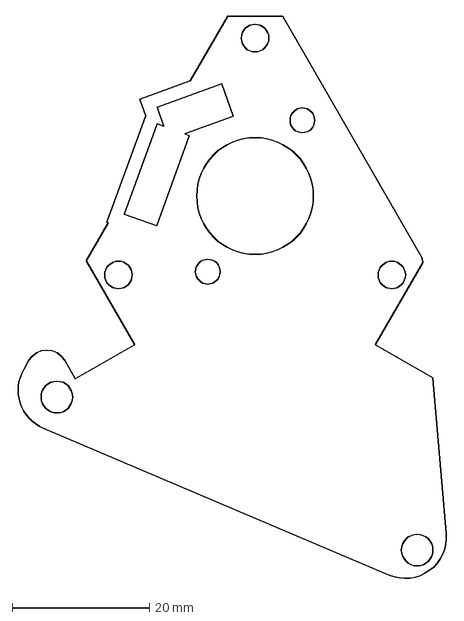
[picture p46: CAD file, 2023-08-05]
Modified designs/STLs/hot-end-mdf-plate-x-section.dxf
62.8 x 82.2 mm
