RepRapLtd/Mendel-V1.0/Print-mendel/Individual-STLs/xlr-bracket-1off.stl

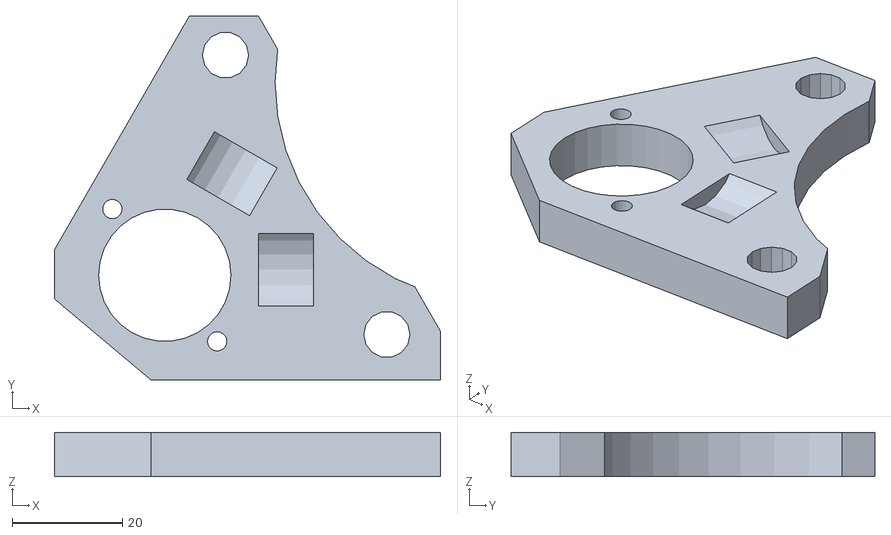
[picture p47: CAD file, 2020-08-14]
Print-mendel/Individual-STLs/xlr-bracket-1off.stl
70.0 x 66.0 x 8.00
