RepRapLtd/Mendel-V1.0/dxf/heater-block.dxf

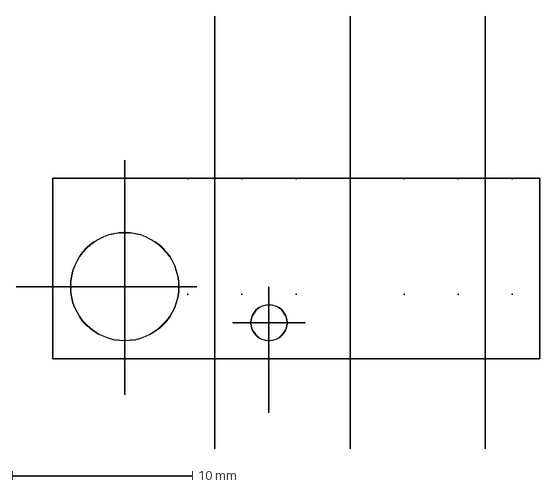
[picture p48: CAD file, 2020-08-14]
dxf/heater-block.dxf
29.0 x 24.0 mm
