RepRapLtd/Mendel-V1.0/Print-mendel/Individual-STLs/fan-duct-bracket.stl

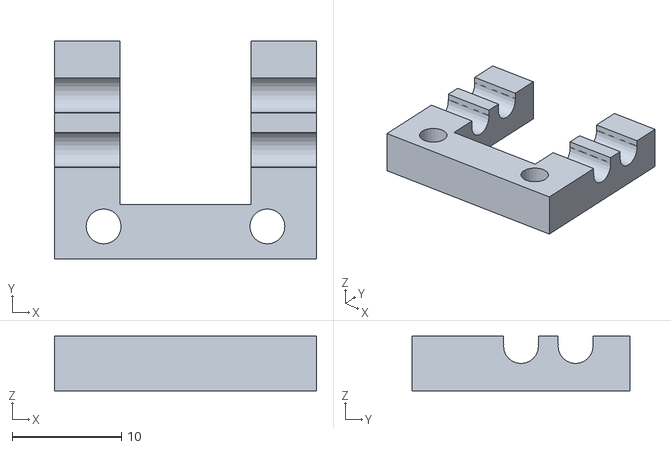
[picture p49: CAD file, 2020-08-14]
Print-mendel/Individual-STLs/fan-duct-bracket.stl
24.0 x 20.0 x 5.00
