RepRapLtd/Mendel-V1.0/dxf/aluminium-heat-spreader.dxf

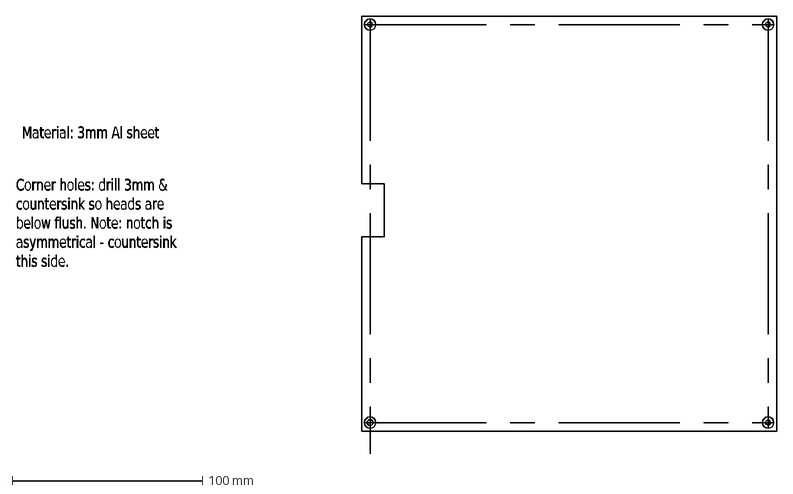
[picture p50: CAD file, 2020-08-14]
dxf/aluminium-heat-spreader.dxf
Material:\~3mm\~Al\~sheet
Corner\~holes:\~drill\~3mm\~& countersink\~so\~heads\~are below\~flush.\~Note:\~notch\~is asymmetrical\~-\~countersink this\~side.
