RepRapLtd/Mendel-V1.0/Print-mendel/Individual-STLs/small-gear-1off.stl

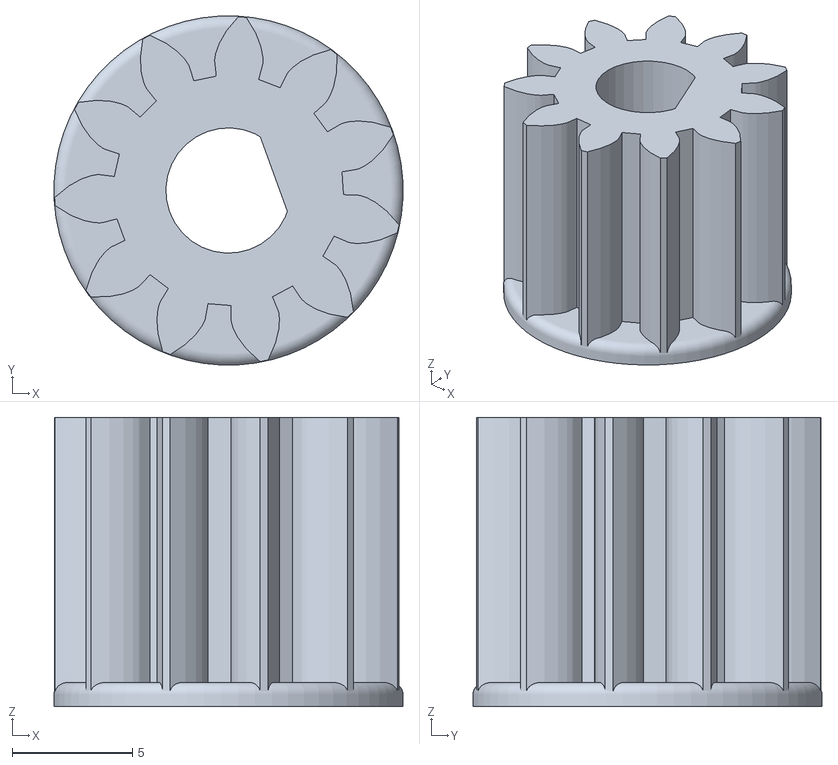
[picture p51: CAD file, 2020-08-14]
Print-mendel/Individual-STLs/small-gear-1off.stl
14.5 x 14.5 x 12.0
