RepRapLtd/Mendel-V1.0/dxf/length-measuring-jig.dxf

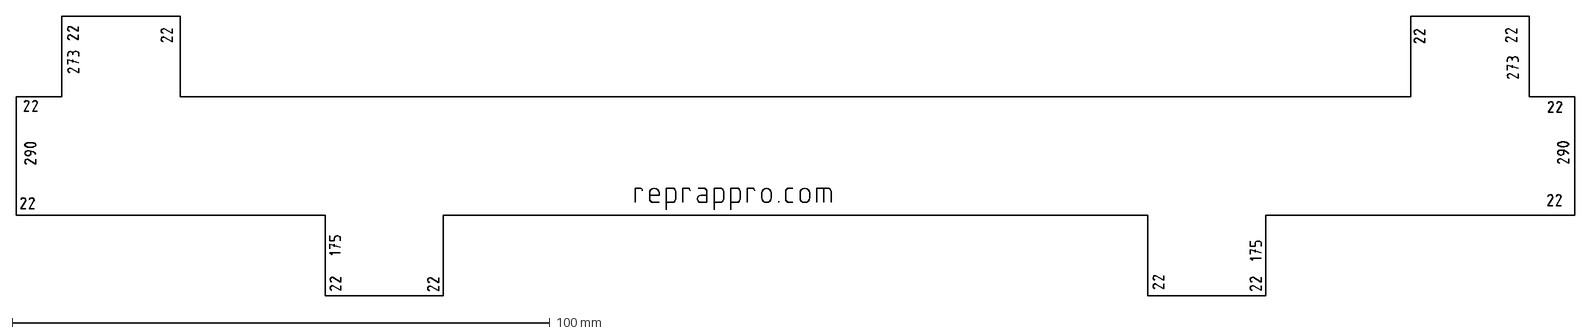
[picture p52: CAD file, 2020-08-14]
dxf/length-measuring-jig.dxf
290.0 x 52.0 mm
