RepRapLtd/Mendel-V1.0/Print-mendel/Individual-STLs/x-belt-clamp-2off.stl

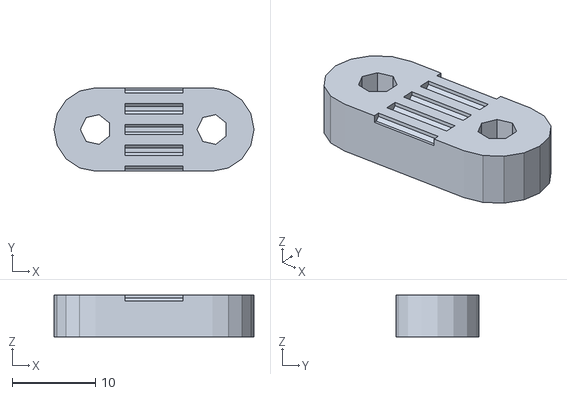
[picture p53: CAD file, 2020-08-14]
Print-mendel/Individual-STLs/x-belt-clamp-2off.stl
24.0 x 10.0 x 5.00
