RepRapLtd/Mendel-V1.0/Print-mendel/Individual-STLs/z-motor-mount-2off.stl

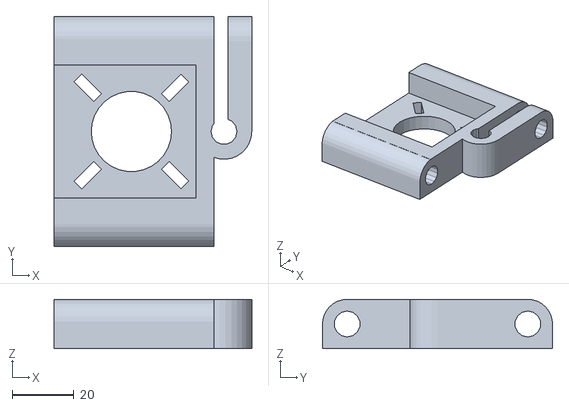
[picture p54: CAD file, 2020-08-14]
Print-mendel/Individual-STLs/z-motor-mount-2off.stl
64.0 x 74.5 x 16.0
