RepRapLtd/Mendel-V1.0/dxf/x-motor-cutout.dxf

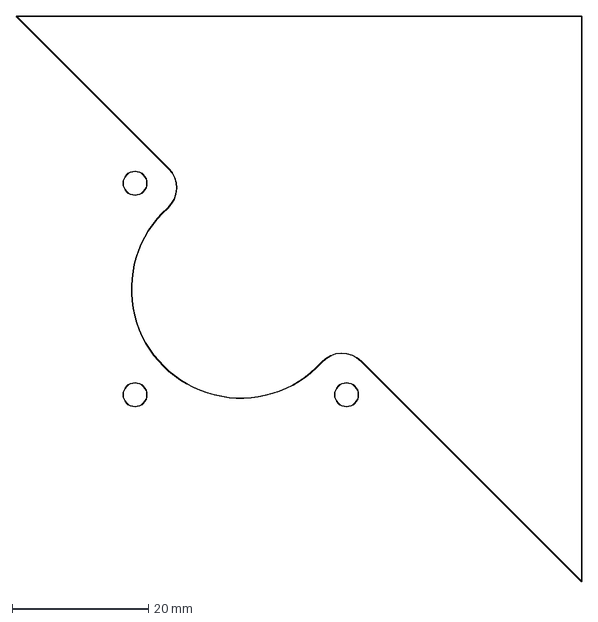
[picture p55: CAD file, 2020-08-14]
dxf/x-motor-cutout.dxf
82.9 x 82.9 mm
