RepRapLtd/Mendel-V1.0/Print-mendel/Individual-STLs/y-belt-tensioner-1off.stl

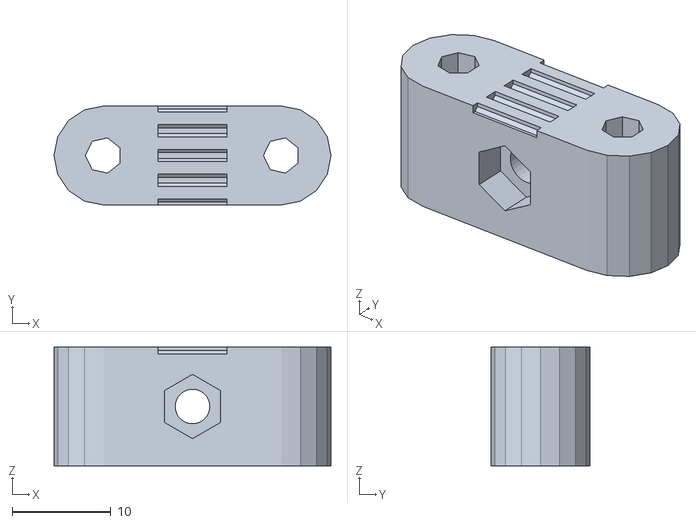
[picture p56: CAD file, 2020-08-14]
Print-mendel/Individual-STLs/y-belt-tensioner-1off.stl
28.0 x 10.0 x 12.0
