RepRapLtd/Mendel-V1.0/dxf/heatbed-insulator.dxf

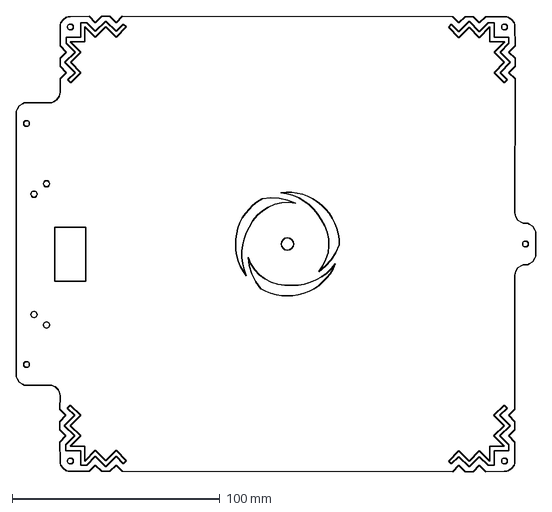
[picture p57: CAD file, 2020-08-14]
dxf/heatbed-insulator.dxf
250.2 x 219.3 mm
