RepRapLtd/Mendel-V1.0/Print-mendel/Individual-STLs/y-bearing-mount-3off.stl

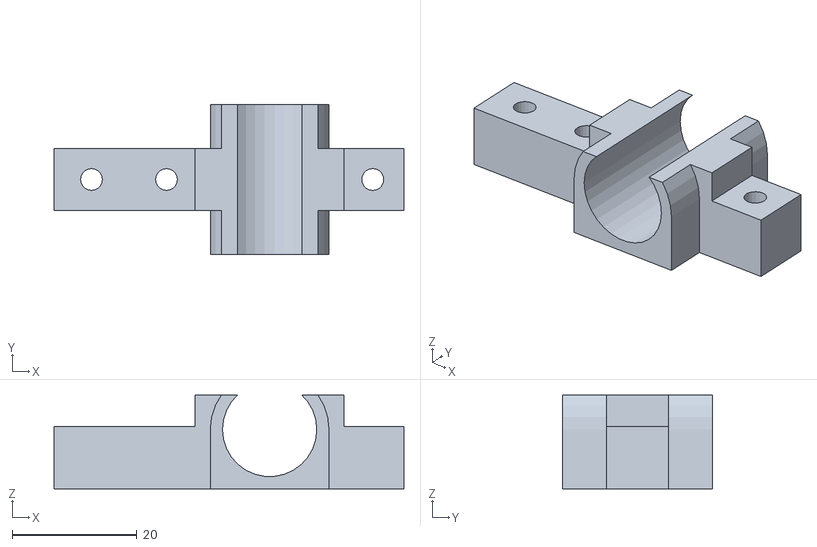
[picture p58: CAD file, 2020-08-14]
Print-mendel/Individual-STLs/y-bearing-mount-3off.stl
56.0 x 24.0 x 15.0
