RepRapLtd/Mendel-V1.0/dxf/one-piece-nozzle.dxf

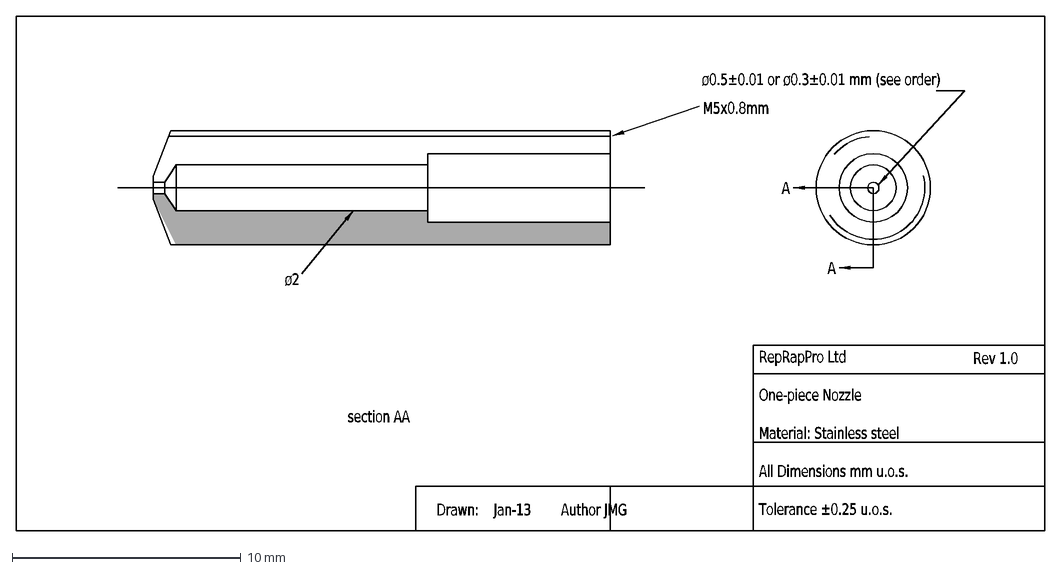
[picture p59: CAD file, 2020-08-14]
dxf/one-piece-nozzle.dxf
A
section AA
M5x0.8mm
ø2
ø0.5±0.01 or ø0.3±0.01 mm (see order)
RepRapPro Ltd One-piece Nozzle Material: Stainless steel All Dimensions mm u.o.s. Tolerance ±0.25 u.o.s.
Drawn: Jan-13 Author JMG
Rev 1.0
