RepRapLtd/Mendel-V1.0/Print-mendel/Individual-STLs/y-belt-clamp-3off.stl

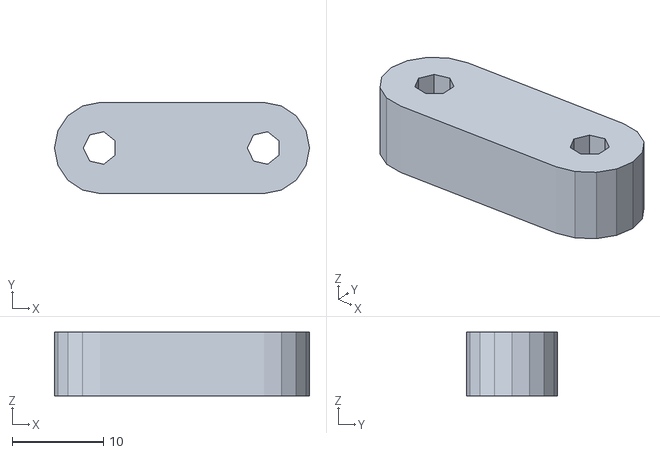
[picture p60: CAD file, 2020-08-14]
Print-mendel/Individual-STLs/y-belt-clamp-3off.stl
28.0 x 10.0 x 7.00
