RepRapLtd/Mendel-V1.0/Print-mendel/Individual-STLs/y-belt-low-1off.stl

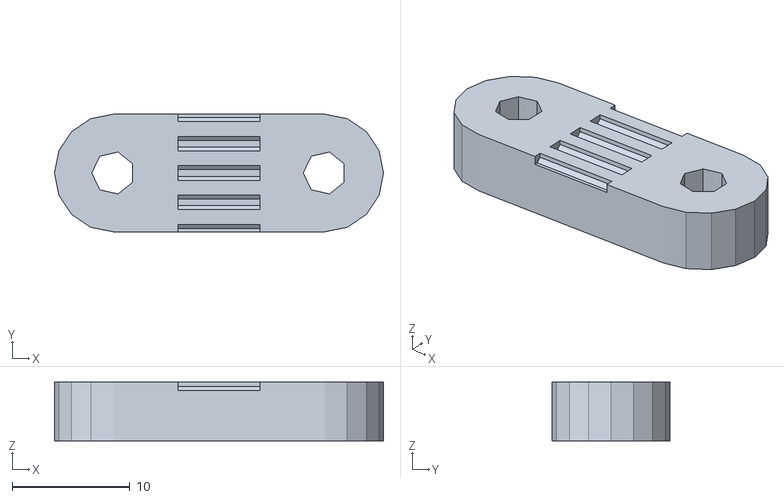
[picture p61: CAD file, 2020-08-14]
Print-mendel/Individual-STLs/y-belt-low-1off.stl
28.0 x 10.0 x 5.00
