RepRapLtd/Mendel-V1.0/Print-mendel/Individual-STLs/pulley-2off.stl

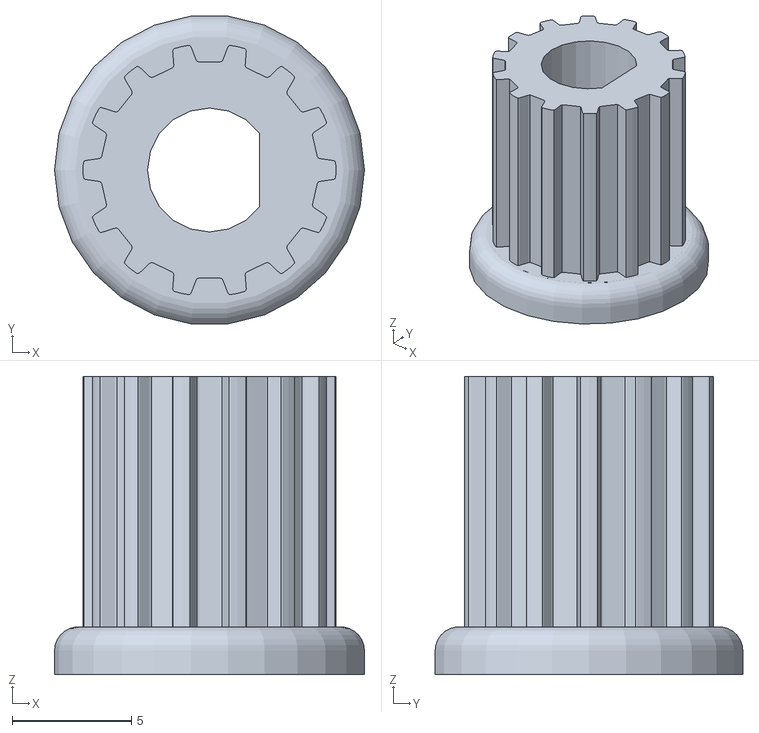
[picture p62: CAD file, 2020-08-14]
Print-mendel/Individual-STLs/pulley-2off.stl
13.0 x 12.9 x 12.5
