RepRapLtd/Mendel-V1.0/Print-mendel/Individual-STLs/frame-vertex-foot-l-2off.stl

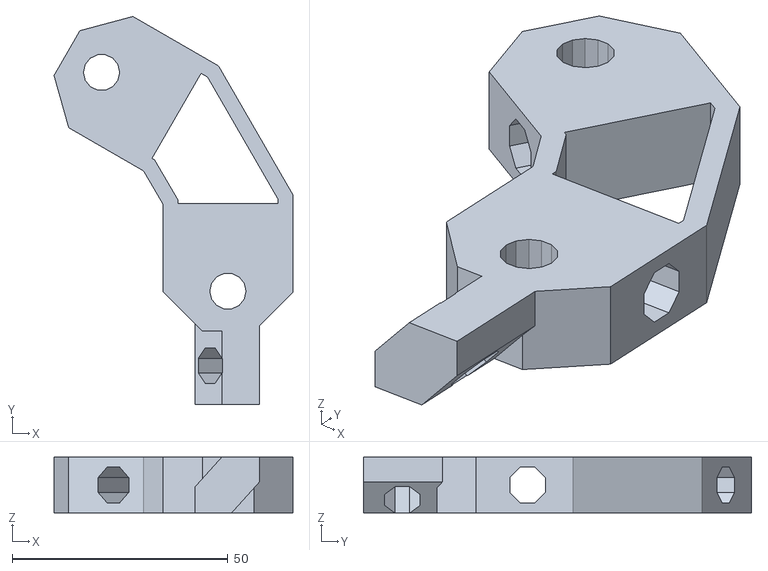
[picture p63: CAD file, 2020-08-14]
Print-mendel/Individual-STLs/frame-vertex-foot-l-2off.stl
55.4 x 89.9 x 12.9
