RepRapLtd/Mendel-V1.0/Print-mendel/Individual-STLs/ps-cover-1off.stl

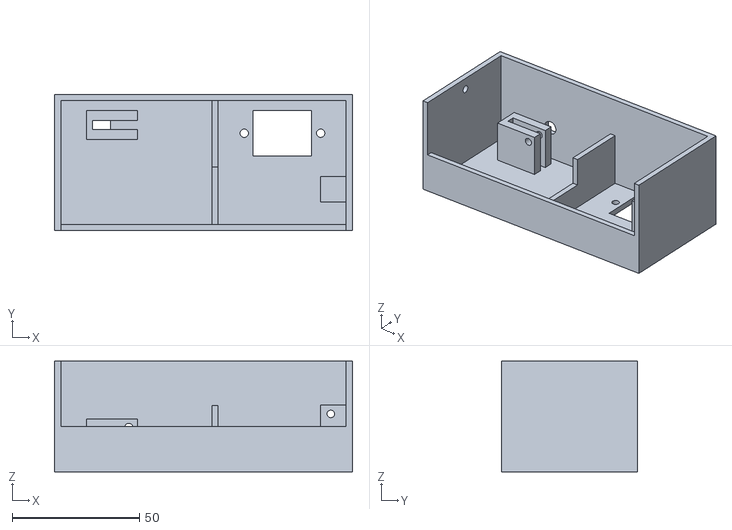
[picture p64: CAD file, 2020-08-14]
Print-mendel/Individual-STLs/ps-cover-1off.stl
117.0 x 53.5 x 43.5
