RepRapLtd/Mendel-V1.0/Print-mendel/Individual-STLs/M6-Block-2off.stl

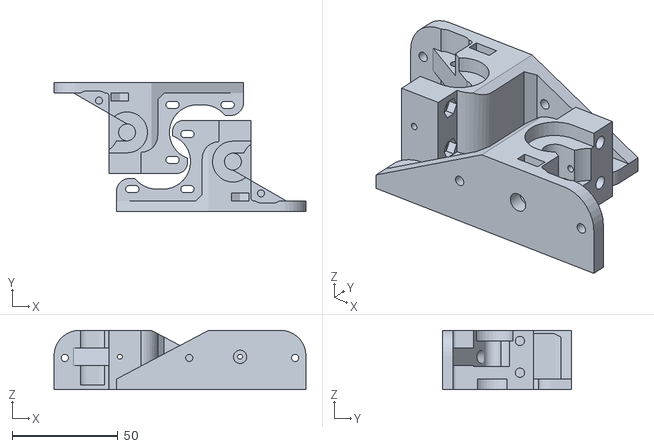
[picture p65: CAD file, 2020-08-14]
Print-mendel/Individual-STLs/M6-Block-2off.stl
119.0 x 61.0 x 28.0
