RepRapLtd/Mendel-V1.0/Print-mendel/Individual-STLs/idler-dont-print-me.stl

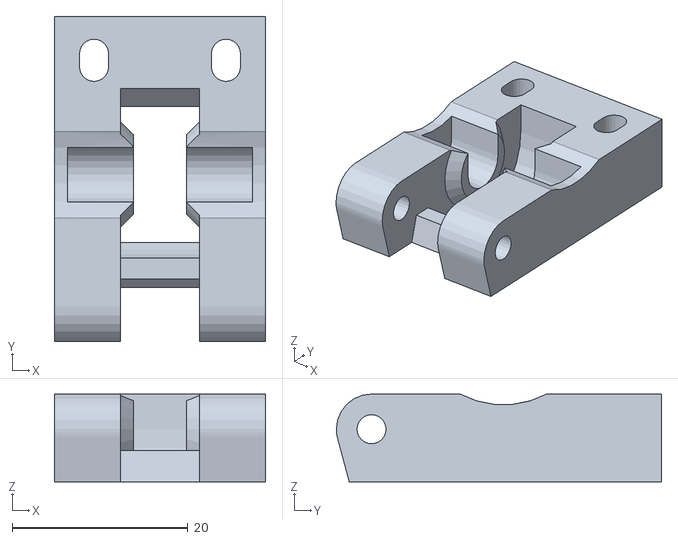
[picture p66: CAD file, 2020-08-14]
Print-mendel/Individual-STLs/idler-dont-print-me.stl
24.0 x 37.0 x 10.0
