RepRapLtd/Mendel-V1.0/Print-mendel/Individual-STLs/frame-vertex-2off.stl

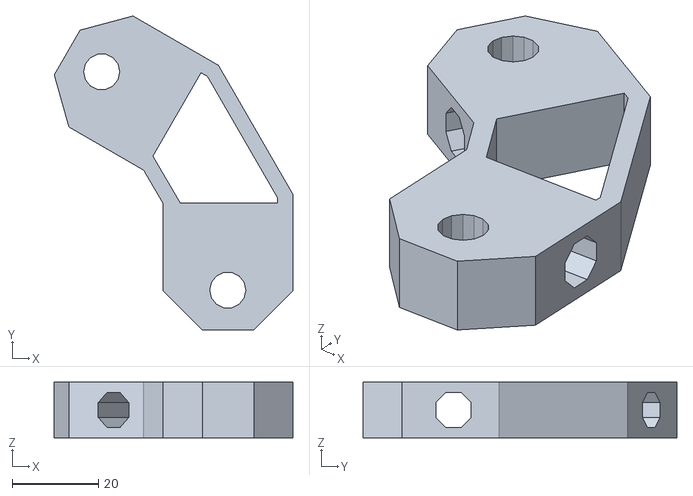
[picture p67: CAD file, 2020-08-14]
Print-mendel/Individual-STLs/frame-vertex-2off.stl
55.4 x 72.9 x 12.9
