RepRapLtd/Mendel-V1.0/Print-mendel/Individual-STLs/x-end-idler-1off.stl

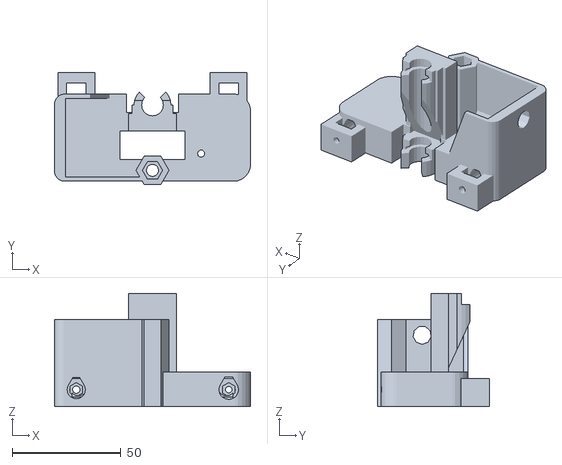
[picture p68: CAD file, 2020-08-14]
Print-mendel/Individual-STLs/x-end-idler-1off.stl
90.0 x 51.6 x 52.0
