RepRapLtd/Mendel-V1.0/Print-mendel/Individual-STLs/fan-duct.stl

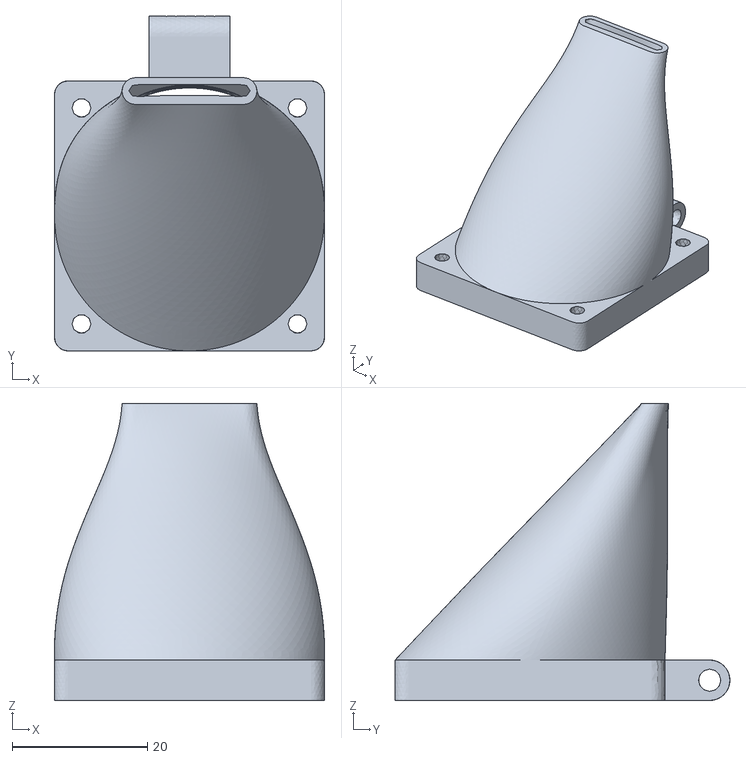
[picture p69: CAD file, 2020-08-14]
Print-mendel/Individual-STLs/fan-duct.stl
40.0 x 49.6 x 44.0
