RepRapLtd/Mendel-V1.0/Print-mendel/Individual-STLs/bar-clamp-8off.stl

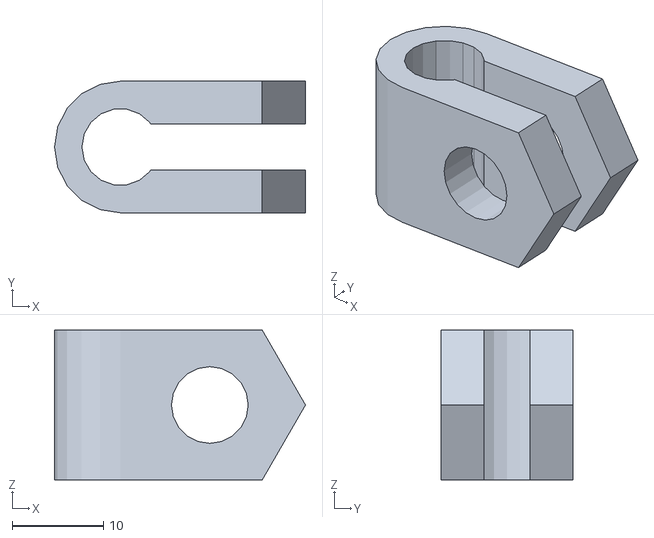
[picture p70: CAD file, 2020-08-14]
Print-mendel/Individual-STLs/bar-clamp-8off.stl
27.5 x 14.4 x 16.4
