RepRapLtd/Mendel-V1.0/Print-mendel/Individual-STLs/thumb-wheel-1off.stl

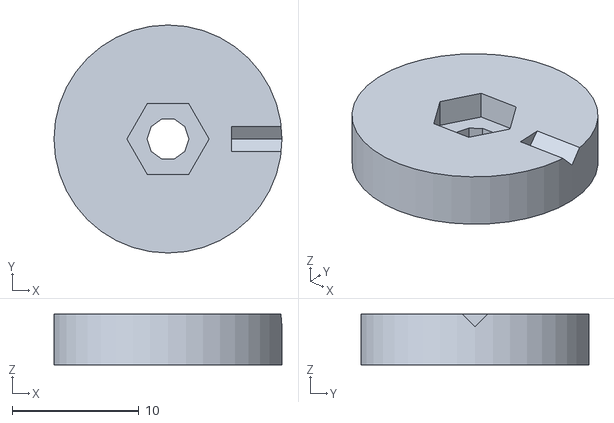
[picture p71: CAD file, 2020-08-14]
Print-mendel/Individual-STLs/thumb-wheel-1off.stl
18.0 x 18.0 x 4.00
