RepRapLtd/Mendel-V1.0/Print-mendel/Individual-STLs/z-endstop-1off.stl

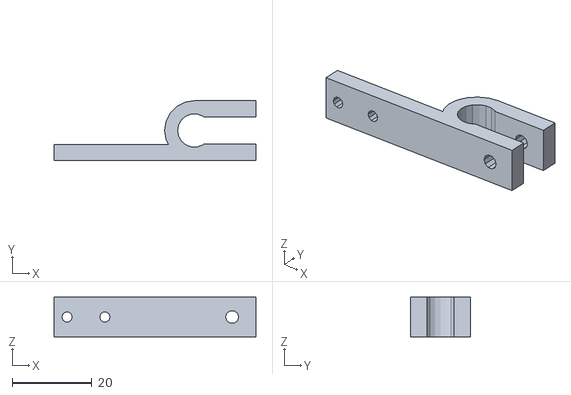
[picture p72: CAD file, 2020-08-14]
Print-mendel/Individual-STLs/z-endstop-1off.stl
50.8 x 15.0 x 10.0
