RepRapLtd/Mendel-V1.0/Print-mendel/Individual-STLs/extruder-drive-mount-1off.stl

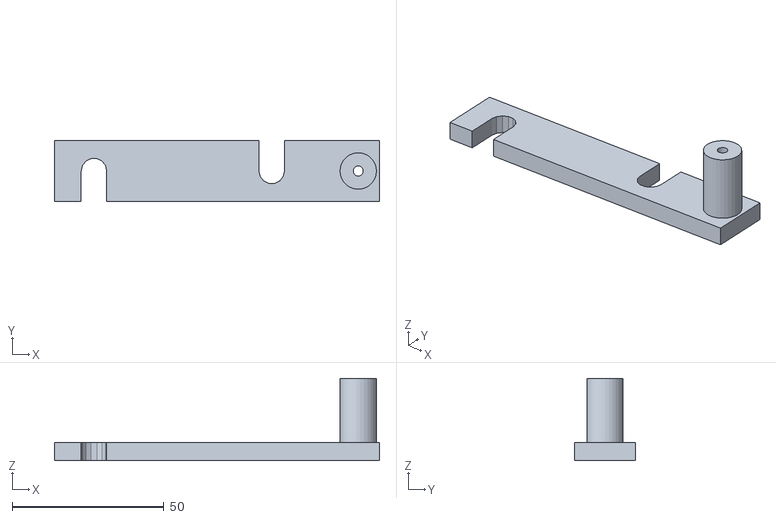
[picture p73: CAD file, 2020-08-14]
Print-mendel/Individual-STLs/extruder-drive-mount-1off.stl
107.0 x 20.0 x 27.0
