RepRapLtd/Mendel-V1.0/Print-mendel/Individual-STLs/belt-guide-3off.stl

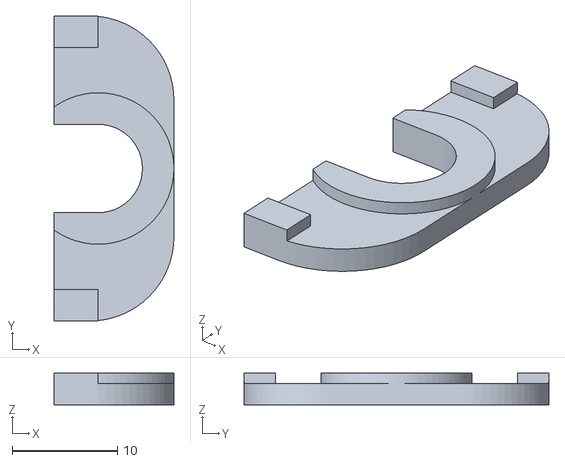
[picture p75: CAD file, 2020-08-14]
Print-mendel/Individual-STLs/belt-guide-3off.stl
11.4 x 29.0 x 3.00
