RepRapLtd/Mendel-V1.0/Print-mendel/Individual-STLs/y-motor-mount-1off.stl

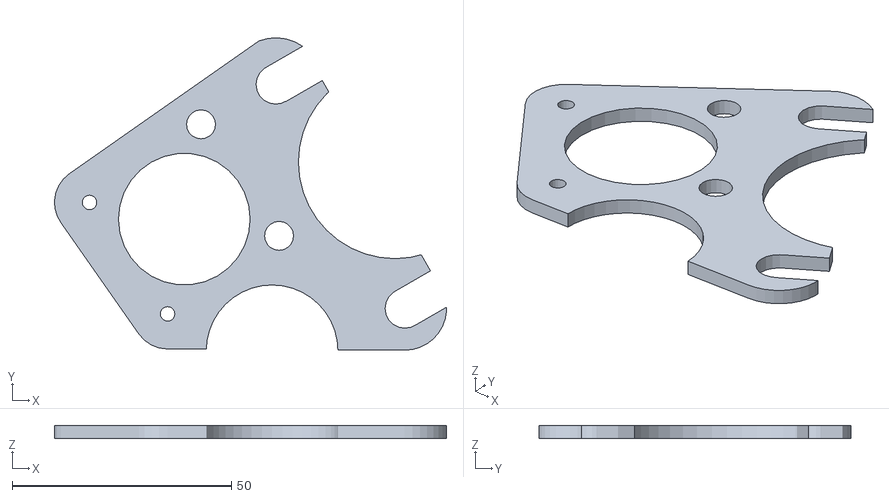
[picture p76: CAD file, 2020-08-14]
Print-mendel/Individual-STLs/y-motor-mount-1off.stl
89.3 x 71.2 x 3.00
