RepRapLtd/Mendel-V1.0/Print-mendel/Individual-STLs/y-endstop-holder-1off.stl

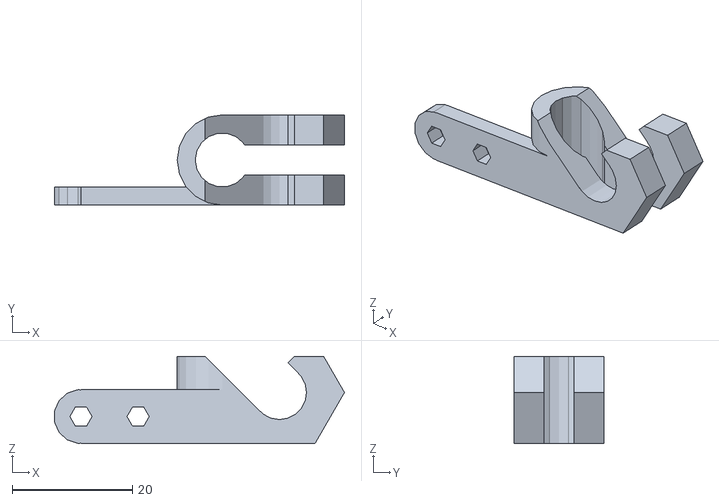
[picture p77: CAD file, 2020-08-14]
Print-mendel/Individual-STLs/y-endstop-holder-1off.stl
48.2 x 15.0 x 14.5
