RepRapLtd/Mendel-V1.0/(list of files, cad)

Other CAD files:
Mult-material/Print-mendel-mult-material/Individual-STLs/tongue-1off.stl
Print-mendel/Individual-STLs/frame-vertex-foot-r-2off.stl
Print-mendel/Individual-STLs/pcb-clip-4off.stl
Print-mendel/Individual-STLs/x-carriage-plate-1off.stl
Print-mendel/Individual-STLs/frame-vertex-foot-4off.stl
Print-mendel/Individual-STLs/y-belt-guide-1off.stl
Print-mendel/Individual-STLs/idler-1off.stl
Print-mendel/Individual-STLs/y-motor-mount-plate-1off.stl
Print-mendel/Individual-STLs/x-carriage-lid-1off.stl
Quickset-x-lid/mendel-1-x-lid.scad
Openscad/parametric_involute_gear_v5.0.scad
Quickset-x-carriage/configuration.scad
FreeCAD/PCB-clip-offset-screw-long-Chamfer001.stl
FreeCAD/PCB-clip-offset-screw-long.FCStd
FreeCAD/PCB-clip-offset-screw.FCStd
Modified designs/STLs/smart-effector-x-carriage-washer.stl
Modified designs/STLs/smart-effector-x-carriage.stl
Modified designs/STLs/switch-probe-x-carriage.stl
Mult-material/Openscad/config.scad
Mult-material/Openscad/extruder-drive.scad
Mult-material/Openscad/gears.scad
Mult-material/Openscad/library.scad
Mult-material/Openscad/parametric_involute_gear_v5.0.scad
Mult-material/Openscad/spacer-1off.scad
Openscad/bar-clamp-8off.scad
Openscad/bar-clamp-hook-8off.scad
Openscad/belt-guide.scad
Openscad/coupling-4off.scad
Openscad/e-nut-retainer-readme.scad
Openscad/endstop-holder-pcb-clip-readme.scad
Openscad/extruder-drive-mount-1off.scad
Openscad/fan-duct-bracket.scad
Openscad/frame-vertex-readme.scad
Openscad/hot-end-pcb-bracket-1off.scad
Openscad/idler.scad
Openscad/mendel-gears-readme.scad
Openscad/ps-cover-1off.scad
Openscad/pulley-2off.scad
Openscad/thumb-wheel-1off.scad
Openscad/tongue-1off.scad
Openscad/tube-clamp-4off.scad
Openscad/x-carriage-readme.scad
Openscad/x-end-readme.scad
Openscad/xlr-bracket-1off.scad
Openscad/y-bearing-mount-3off.scad
Openscad/y-motor-mount-readme.scad
Openscad/z-motor-mount-2off.scad
Print-mendel/Individual-STLs/M6-Block-2off_stl.scad
Print-mendel/Individual-STLs/PCB-clip-offset-screw.stl
Quickset-x-carriage/bearing-mount-include.scad
Quickset-x-carriage/belt-clamp-readme.scad
Quickset-x-carriage/functions.scad
dxf/tapered-nut.dxf
