RepRapLtd/Mendel-V1.0/Print-mendel/Individual-STLs/README

For one RepRapPro Mendel print the number off of each part that the file name says.

See http://reprappro.com/Mendel
