RepRapLtd/Mendel-V1.0/Print-mendel/Mendel-trays-RFOs/tray-1.png

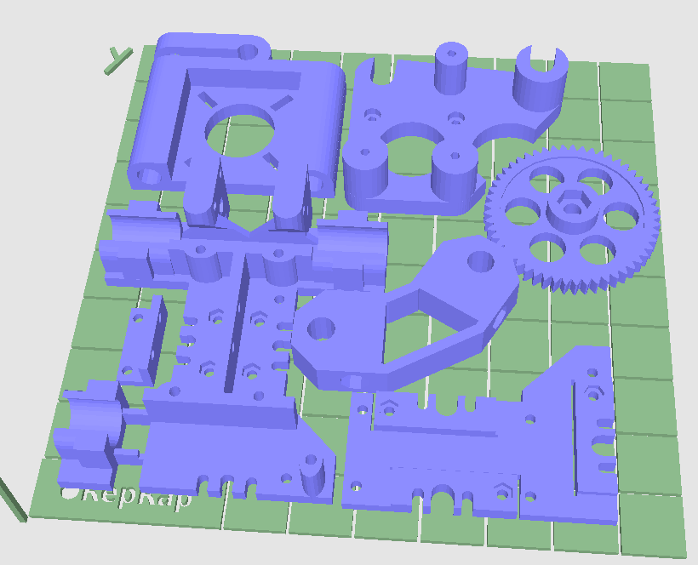
Print-mendel/Mendel-trays-RFOs/tray-1.png
