RepRapLtd/Mendel-V1.0/(list of files, drawings)

Other design files:
gEDA/Heatbed/heatbed.new.pcb
gEDA/Heatbed/heatbed.pcb
