RepRapLtd/Mendel-V1.0/Modified designs/Electronics/hot-end-connector/GCode/front.g

; pcb2gcode 2.0.0 
; Software-independent Gcode 

G94 ; Millimeters per minute feed rate. 
G21 ; Units == Millimeters. 

G90 ; Absolute coordinates. 
;G1 F3000 S10000 ; RPM spindle speed. 
G1 F300 F600.00000 ; Feedrate. 


G1 F3000 Z3.00000 ;Retract to tool change height
;T0
;M5      ;Spindle stop.
;G04 P1.00000 ;Wait for spindle to stop
;MSG, Change tool bit to mill diameter 0.12000mm
;M6      ;Tool change.
;M0      ;Temporary machine stop.
;M3 ; Spindle on clockwise. 
;G04 P1.00000 ;Wait for spindle to get up to speed
;G04 P0 ; dwell for no time -- G64 should not smooth over this point 
G1 F3000 Z3.00000 ; retract 

G1 F3000 X0.63532 Y21.78373 ; rapid move to begin. 
G1 F300 F300.00000
G1 F300 Z-0.07000
;G04 P0 ; dwell for no time -- G64 should not smooth over this point 
G1 F300 F600.00000
G1 F300 X0.63532 Y21.78373
G1 F300 X0.65488 Y21.60082
G1 F300 X0.71142 Y21.42574
G1 F300 X0.81274 Y21.25025
G1 F300 X0.93608 Y21.11375
G1 F300 X1.08472 Y21.00535
G1 F300 X1.26984 Y20.92292
G1 F300 X1.45615 Y20.88467
G1 F300 X1.63385 Y20.88467
G1 F300 X1.82620 Y20.92455
G1 F300 X1.95157 Y20.98002
G1 F300 X4.21446 Y20.98002
G1 F300 X6.59721 Y18.59727
G1 F300 X6.72500 Y18.49352
G1 F300 X6.86553 Y18.41970
G1 F300 X7.01776 Y18.37472
G1 F300 X7.16998 Y18.36004
G1 F300 X11.17000 Y18.36004
G1 F300 X11.32219 Y18.37472
G1 F300 X11.47442 Y18.41970
G1 F300 X11.61495 Y18.49352
G1 F300 X11.73837 Y18.59331
G1 F300 X14.38051 Y21.23504
G1 F300 X28.88500 Y21.23504
G1 F300 X28.89511 Y21.16168
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
G1 F300 X29.88383 Y3.35966
G1 F300 X29.69985 Y3.35999
G1 F300 X29.51985 Y3.39791
G1 F300 X29.33473 Y3.48034
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

;G04 P0 ; dwell for no time -- G64 should not smooth over this point 
G1 F3000 Z3.000 ; retract 

;M5 ; Spindle off. 
;G04 P1.000000
;M9 ; Coolant off. 
M0 ; Program end. 
