RepRapLtd/Mendel-V1.0/(commit log)

2020-08-14 First commit.
    [M6-Block-1off.stl, M6-Block-2off.stl, M6-Block-2off_stl.scad, RepRapPro-Mendel-BoM.ods, Tray1B.stl, Tray2B.stl, Tray3B.stl, alternate-cooling-block.dxf]
2020-08-14 Tidying file names.
    [bearing-mount-include.scad, belt-clamp-readme.scad, configuration.scad, functions.scad, mendel-1-x-carriage-plate-and-lid.scad, mendel-1-x-carriage-plate.stl, mendel-1-x-lid.stl, x-carriage.FCStd]
2020-08-18 Correcting X-carriage design.
    [mendel-1-x-carriage-plate-and-lid.scad, mendel-1-x-carriage-plate.stl, mendel-1-x-lid.stl, x-carriage-and-lid.FCStd, x-carriage.FCStd, x-lid.FCStd]
2023-07-14 Adding touch-probe hot end design.
    [PCB-clip-offset-screw-long-Chamfer001.stl, PCB-clip-offset-screw-long.FCStd, PCB-clip-offset-screw.FCStd, PCB-clip-offset-screw.stl, X Carriage - bed probe bearing holder check.stl, X Carriage - bed probe.FCStd, config.g, fan.stl]
2023-07-25 New hot end WIP.
    [X Carriage - bed probe.FCStd, hot-end-body.stl, hot-end-cool-duct.stl, hot-end-mdf-plate-x-section.dxf, hot-end-spacer.stl, hot-end.FCStd]
2023-07-28 Final design?
    [hot-end-body.stl, hot-end-cool-duct.stl, hot-end.FCStd]
2023-07-29 Laser files
    [hot-end-mdf-plate-x-section.dxf, hot-end.FCStd]
2023-07-30 Adjust mount hole depths.
    [hot-end-body.stl]
2023-08-05 Final? probe carriage and hot end design.
    [carriage.stl, contact-mount.stl, hot-end-mdf-plate-x-section.dxf, hot-end.FCStd]
2023-08-29 PCB for new hot end connector WIP
    [drill.g, front.g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]
2023-08-30 Hot end PCB WIP
    [hot-end-connector.kicad_sch]
2023-08-31 Final (?) PCB design.
    [contact-mount-2-off.stl, contact-mount-mirror-1-off.stl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]
2023-09-18 Repositioning X belt clamps etc.
    [hot-end-body.stl, hot-end-cool-duct.stl, hot-end-spacer.stl, hot-end.FCStd]
2023-10-23 Setting up Duet WIP
    [bed.g, carriage.stl, config.g, homeall.g, homex.g, homey.g, homez.g, hot-end.FCStd]
2023-11-15 Bed contact design started.
    [bed-mount.FCStd]
2024-02-01 Started work on smart effector Duet3D design.
    [bed-mount-block+60.stl, bed-mount-block-0.stl, bed-mount-block-60.stl, bed-mount.FCStd, smart-effector-x-carriage.FCStd]
2024-02-08 Changed cone support to flexing strip.
    [smart-effector-x-carriage-spacer.stl, smart-effector-x-carriage.FCStd]
2024-02-18 Next version of smart effector carriage.
    [smart-effector-x-carriage-carriage.stl, smart-effector-x-carriage.FCStd]
2024-02-27 With added print cooling.
    [bar-clamp-8off.g, smart-effector-x-carriage.FCStd]
2024-02-28 Final (?) print cooler design.
    [smart-effector-lower-duct.stl, smart-effector-x-carriage.FCStd, smart-effector-x-carriage.stl]
2024-02-29 New fan/duct design. WIP.
    [smart-effector-x-carriage.FCStd]
2024-03-01 New print cooling duct WIP.
    [smart-effector-x-carriage-duct-e.stl, smart-effector-x-carriage.FCStd]
2024-03-04 Final (?) design of X carriage.
    [bed-mount-block+60.stl, bed-mount-block-0.stl, bed-mount-block-60.stl, carriage.stl, contact-mount-2-off.stl, contact-mount-mirror-1-off.stl, contact-mount.stl, hot-end-body.stl]
2024-05-09 Starting work on hot end with simple z probe switch.
    [switch-probe-x-carriage-spring-test.stl, switch-probe-x-carriage.FCStd]
2024-05-10 Switch probe final (?) design.
    [switch-probe-x-carriage-lever.stl, switch-probe-x-carriage.FCStd, switch-probe-x-carriage.stl]
2024-06-14 Simplified design.
    [switch-probe-contact-bridge.stl, switch-probe-x-carriage-lever.stl, switch-probe-x-carriage.FCStd, switch-probe-x-carriage.stl]
